Potaeeatsthis/2026-micro-con/study/voice_command_state.pdf

S0 Idle awaits for trigger words

S1 Object wait wait for user say the object

seen by pi

move / pick / grab

blue box/ green box / red box / black box

LCD show the object that user say on the screen to confirm

S2 Grasp confirm On LCD : pick BLUE BOX - yes?

yes

S3 Grasping arm move and pick the object

S4 Holding the object holded and wait

for the command

S5 Destination to designated destination

hand / station / default | | forward / backward / left / right
place / drop | | LCD : [forward 10, right 5, left 5] confirm? | The numbers on the slide bar indicate the distance of the movement in centimeters.
| pop the jog queue | | S6 Jog queue add movement step in a queue that shown on LCD
| yes

S8a Executing runs the steps in the queue

no

S7 Plan confirm LCD show the plan

yes

S8b Executing move&place, also can be

interupt by “stop”

S9 Release lower, open and retreat to home

S10 Stopped stopped but still hold the object

stop

### Lower and open the hand Go to Homeplace / drop

home

only when gripper open

GLOBAL RULE: "stop" is accepted in every state.
- while the arm moves (S3, S8a, S8b, S9, Go to Home) -> S10 Stopped
- while waiting (S1, S2, S4, S6, S7) | -> cancel, back to S0/S4

no

no

undo
