Potaeeatsthis/2026-micro-con/voice_command_research/workspace/eval/baseline_w16d2_noaug/S0/clip_confusion.png

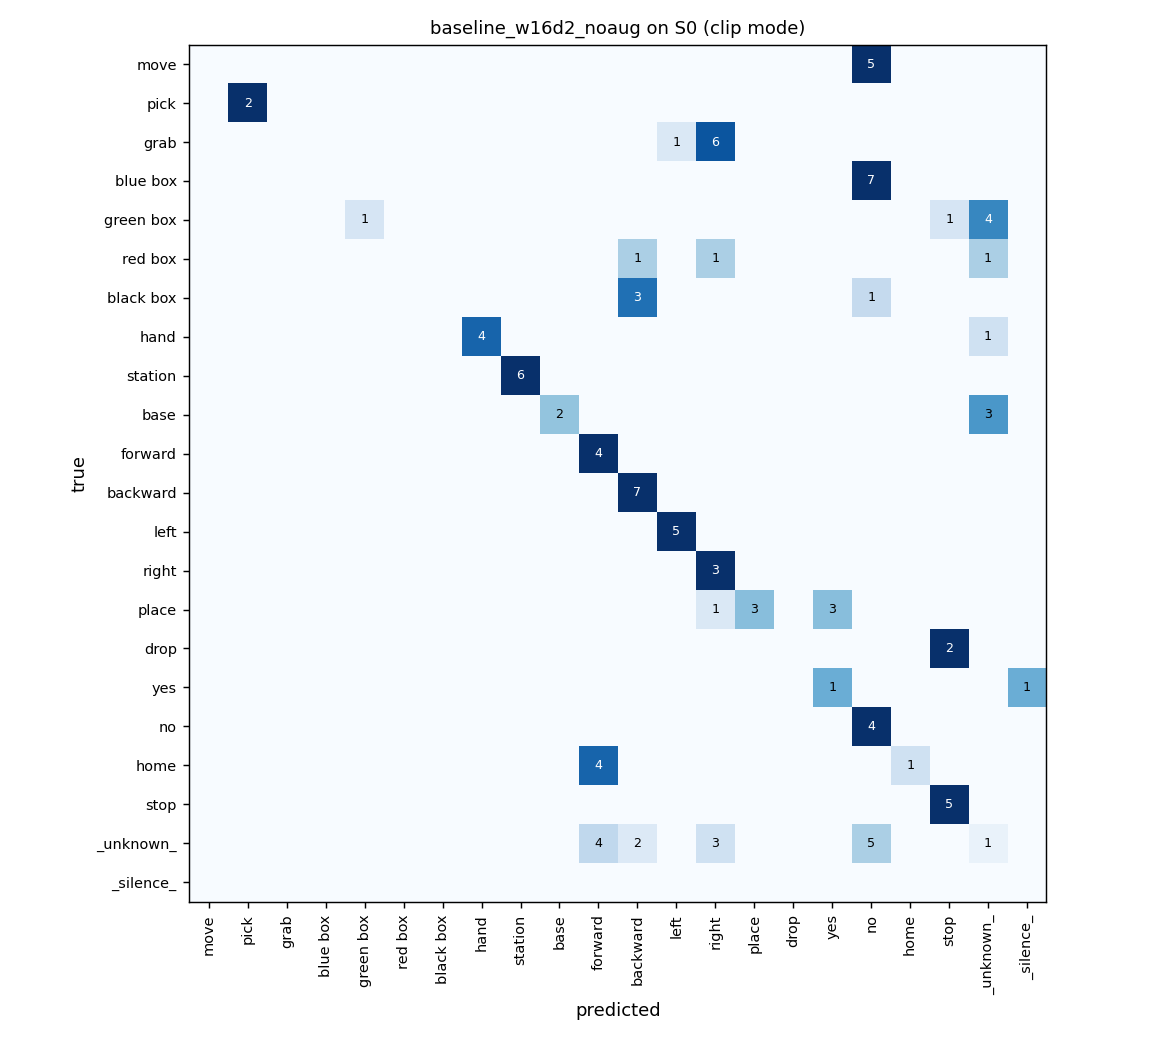
voice_command_research/workspace/eval/baseline_w16d2_noaug/S0/clip_confusion.png
