Potaeeatsthis/2026-micro-con/study/robotic-arm-budget.xlsx

Sheet: Parts List
Parts List
Microcontroller Project · Third Year Computer Engineering · Budget cap ฿5,000 · Updated 8 September 2026
# | Part | Why we need it | Qty | Price each | Total | Where to buy | Link | Price checked?
 | MG996R servo motor | The three heavy joints: base rotation, shoulder and elbow. These carry the whole weight of the arm above them. We buy 4 so there is 1 spare, because a burnt motor mid-project costs a week. | 4 | ฿139 | ฿556 | ModuleMore | Buy here (https://www.modulemore.com/en/product/524/เซอร์โว-0-180-องศา-mg996r-servo-robot-รุ่นอัพเกรดจาก-mg995-เฟืองโลหะล้วน) | Yes, price seen
 | SG90 Micro Servo Motor + Horn | The three light joints: wrist pitch, wrist rotation and the gripper. Small and light, which matters because every gram out here multiplies the load on the shoulder. 4 for 1 spare. | 4 | ฿70 | ฿280 | Cybertice | Buy here (https://www.cybertice.com/product/935/sg90-micro-servo-motor-แบบ-หมุน360องศาต่อเนื่อง) | Yes, price seen
 | SN74AHCT244N DIP-20 logic buffer | Receives the six 3.3 V STM32 hardware-PWM signals and outputs reliable 5 V servo-control signals. One eight-channel chip supports all six servos. Servo power does not pass through this chip. | 1 | ฿38 | ฿38 | DigiKey Thailand | https://www.ti.com/product/SN74AHCT244 (https://www.modulemore.com/product/9/pca9685-16-channel-pwm-servo-driver) | Yes, price seen
 | INMP441 I2S microphone | Voice input to the Pi. | 3 | ฿85 | ฿255 | Cybertice | Buy here (https://www.cybertice.com/product/4718/inmp441-โมดูลไมโครโฟนรอบทิศทาง-omnidirectional-microphone-module-i2s-interface-mems) | Yes, price seen
 | 10kΩ Potentiometer | One knob per joint for a manual jog mode. Not needed for autonomous operation, but reading 6 ADC channels is real microcontroller work, and it is how you calibrate each joint and demo the arm if speech or vision fails on the day. | 6 | ฿10 | ฿60 | Cybertice | Buy here (https://www.cybertice.com/product/190/wh148-ตัวต้านทานปรับค่าได้-10k-ohm-b10k-volume-vr-potentiometer-variable-resistor) | Yes, price seen
 | Ball bearing 6806ZZ, 30x42x7 | Press-fits into the base. It sits between the fixed base plate and the rotating platform so the base servo is not carrying the arm weight sideways through its own gears. | 1 | ฿132 | ฿132 | Duraprothai | Buy here (https://www.duraprothai.com/product/193478-191425/6806zz-ตลับลูกปืนเม็ดกลมร่องลึก-deep-groove-ball-bearing-30x42x7-mm) | Yes, price seen
 | Fillament(PLA) | Filament (PLA) |  |  | ฿0
 | PETG filament, 1 kg | All the printed arm parts. | 1 | ฿390 | ฿390 | Siamreprap | Buy here (https://siamreprap.bentoweb.com/th/product/1319033/clear-petg-Polylite-Polymaker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) | Yes, price seen
 | LiPo battery, 3S 11.1 V, 2200 mAh, XT60 | Powers the whole robot so it does not need a wall socket. 3S gives 11.1 V nominal. | 1 | ฿590 | ฿590 | Shopee | Buy here (https://shopee.co.th/แบตเตอรี่-Lipo-3S-11.1V-2200mah-35C-สำหรับ-รถบังคับ-เรือ-เครื่องบิน-โดรน-i.17068752.18734467964) | Yes, price seen
 | Buck converter, 20 A 300 W, set to 6.0 V | SERVO RAIL. Battery down to 6.0 V, feeding servos only. Rated 15 A continuous against our 9.75 A worst case. This is what replaces the AAA plan. | 1 | ฿220 | ฿220 | Cybertice | Buy here (https://www.cybertice.com/product/3656/โมดูลแปลงแรงดันลง-20a-300w-step-down-buck-converter-6-40v-to-1-2-35v) | Yes, price seen
 | Buck converter, 5 A, set to 5.1 V | PI RAIL. A separate step-down for the Raspberry Pi. Keeping the Pi off the servo rail is what stops it rebooting every time the arm moves. | 1 | ฿70 | ฿70 | Adruniotics | Buy here (https://www.arduitronics.com/product/3673/step-down-module-sy8205-แปลงไฟจาก-7-24v-เป็น-5v-กระแสสูงสุด-5a-แถมฟรี-pin-headers) | Yes, price seen
 | 100 nF ceramic decoupling capacitor | Connect directly between SN74AHCT244N pin 20 (VCC) and pin 10 (GND). It filters short supply spikes near the logic buffer. | 1 | ฿5 | ฿5 | Local electronics shop | https://www.ti.com/product/SN74AHCT244 (https://shopee.co.th/(1ชิ้น)-NA019-โมดูลแปลงระดับสัญญาณ-logic-4-ช่อง-i2c-5v-เป็น-3.3v-2-ช่อง-IIC-I2C-Logic-Level-Converter-Bi-Directional-...-i.944231623.2098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) | Estimated
 | M2 × 10 mm DIN912 Hex Socket Bolt (20)(5Baht) = 100B M1.6 × 4 mm DIN912 Hex Socket Bolt (10)(8Baht) = 80B M2.5 × 14 mm DIN912 Hex Socket Bolt (20)(4Baht) = 80B | For constructing the 3D printed robotic arm. | 1 | ฿260 | ฿260 | Shopee | Buy here (https://shopee.co.th/-ZY02-TH-X-Hex-Socket-Head-Cap-Machine-Screw-DIN912-น็อตดำ-หัวจม-M1.6-M5-เกรด-12.9-แข็งพิเศษ-สกรูชุบแข็งดำ-เกลียวมิล-i.1381664208.2871545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) | Yes, price seen
 | M2 DIN985 Nyloc Nut (10/set)(5Baht) M2.5 DIN985 Nyloc Nut (10/set)(5Baht) M1.6 DIN934 Hex Nut (10/set)(5Baht) | For constructing the 3D printed robotic arm. | 1 | ฿15 | ฿15 | Shopee | Buy here (https://shopee.co.th/product/1573566645/40768757159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) | Yes, price seen
 | 12 V DC power adapter, 10 A (sealed brick) | Servo power. Feeds the 20 A buck at 6.0 V, so servo conditions match deployment exactly and we test the buck early instead of in the final week. | 1 | ฿215 | ฿215 | ModuleMore | Buy here (https://shopee.co.th/20-JCY-1210-SET-อแดปเตอร์-อะแดปเตอร์-adapter-12v-10a-i.12149540.3343064258) | Yes, price seen
 | Barrel jack to screw terminal adapter (female) | Lets the 12 V adapter plug into the buck without cutting its cable. | 1 | ฿16 | ฿16 | Cytron | Buy here (https://th.cytron.io/p-dc-jack-female-to-screw-terminal-adapter) | Yes, price seen | shopee หมด
 | Terminal block, 12CH, 15A/600V | TWO needed. One strip = PLUS bus (bare wire under all 12 left screws, 12 right screws free for buck+, 6 servo reds, 3 capacitor + legs). Second strip = MINUS bus (buck−, 6 servo blacks, 3 capacitor − legs, 1 wire to Pi/STM32 ground). Splitting one strip 6/6 leaves only 6 usable screws per bus, which is not enough. | 2 | ฿29 | ฿58 | s2ins | Buy here (https://s2ins.com/product/screw-terminal-block-12ch-tb1512-15a-600v/) | Yes, price seen
 | XT60 connector pair male (with 14 AWG pre-soldered) | The yellow RC battery plug. Your pack has one half; you buy the mating half to solder to your wiring so the battery unplugs for charging. | 1 | ฿26 | ฿26 | Shopee | Buy here (https://shopee.co.th/product/428425779/27982717310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) | Yes, price seen
 | Silicone wire 14 AWG + 18 AWG | 14 AWG (2 m red + 2 m black): adapter to buck, buck to Block A, battery junction to both bucks, plus ~30 cm cut into short bus links bridging terminal screws. 18 AWG (1 m + 1 m): Block A out to each servo. Silicone insulation stays flexible on a moving arm. NOT jumper wire — that melts at these currents. | 1 | ฿120 | ฿120 | Shopee | Buy here (https://shopee.co.th/สายไฟซิลิโคน-สายไฟทองแดง-100-แท้-สายอ่อน-ทนความร้อนสูง-8awg-10awg-12awg-14awg-16awg-18awg-20awg-Silicone-200องศา-i.368104632.19578423924) | Yes, price seen
 | Capacitors, 2200 uF 16 V, x3 | Mount across the terminal block. They supply the instant a servo starts, before the converter can react. Three in parallel react faster than one big one. | 3 | ฿50 | ฿150 | Shopee | Buy here (https://shopee.co.th/product/312289360/12295248404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) | Yes, price seen
 | USB-A to micro-USB cable | For connecting Pi - STM32 using UART protocols | 1 | ฿65 | ฿65 | Shopee | Buy here (https://shopee.co.th/สาย-Micro-USB-Type-B-to-USB-2.0-Type-A-ยาว-50CM-มีสินค้าในไืนพร้อมส่งทุกวัน-i.755103386.28367373991) | Yes, price seen
 | Heat shrink tubing | Insulates the XT60 solder split where both buck input pairs join the battery pigtail. Bare copper next to a LiPo is a short waiting to happen. | 1 | ฿102 | ฿102 | Shopee | Buy here (https://shopee.co.th/10M-Heat-Shrink-Tube-2-1-Polyolefin-Diameter-0.6mm-0.8mm-1mm-1.5mm-2mm-2.5mm-3mm-หดความร้อนหลอด-โพลีโลฟินเส้นผ่านศูนย์กลาง-ความร้อนสายแขน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) | Yes, price seen
 | Jumper wires, 3 x 40-way sets | *** เราอาจจะมีอยู่แล้ว *** Male-male and male-female | 1 | ฿120 | ฿120 | ModuleMore | Buy here (https://www.modulemore.com/en/category/43/jumper-connector-protoboard) | Yes, price seen
 | B3 Balance Charger 20 W for 2S / 3S LiPo | A 3S LiPo must only be charged on a proper balance charger. | 1 | ฿245 | ฿245 | cybertice | Buy here (https://www.cybertice.com/product/5590/เครื่องชาร์จแบตเตอรี่ลิเธียมชาร์จประจุกระแสสูงได้อย่างรวดเร็ว-lipo-imax-rc-b3-20w-2s-3s-7-4v-11-1v) | Yes, price seen
 | STM32 board (STM32F767ZI) | Already have it. Generates six stable hardware-PWM signals, reads the controls and safety inputs, plans smooth trajectories, and communicates with the Pi over USB UART. | 1 | ฿0 | ฿0 | We have it |  | Free
 | Raspberry Pi 4 | Already have it. Speech, camera, joint angle maths, and sending commands to the STM32. | 1 | ฿0 | ฿0 | We have it |  | Free
 | Breadboard | Holds the 6 potentiometers and their wiring tidily. | 1 | ฿0 | ฿0 | We have it |  | Free
 | RGB-D camera | Borrowed from a friend. It finds the cube and measures how far away it is. | 1 | ฿0 | ฿0 | Borrowed |  | Free
 | Parts total |  |  |  | ฿3988 |  |  | Passed
 | Shipping | We order from about 3 shops. Each charges ฿50 to ฿70. |  |  | ฿250 |  |  | In review
 | Spare money | In case we burn a motor, buy the wrong screws, or a guessed price is too low. |  |  | ฿300
 | TOTAL |  |  |  | ฿4538
 | 3
 | Optional extras, NOT included in the total above
 | Part | When we would buy it |  | Price |  | Where | Link
 | 8th MG996R, second spare | Top budgeted 2 spares. We budget 1. Add this if motors start dying. |  | ฿139 |  | ModuleMore | Buy here
 | Emergency stop button 22 mm | ADDED. LAY37-11ZS mushroom latching, 1NO+1NC, 10 A. Press to stop the arm when the code sends it somewhere wrong — the fuse cannot detect that. |  | ฿45 |  | Vongjorn | Buy here (https://www.vongjorn.com/product/5207/emergency-stop-button-lay37-11zs-1no-1nc)
 | DS3218 20 kg-cm servo | Only if the shoulder droops when the arm reaches out. Buy it after we build the arm and see, not before. |  | ฿500 |  | Shopee | Buy here
 | FINAL CONTROL AND POWER ARCHITECTURE
 | Control | Raspberry Pi → USB UART → STM32 → six hardware-PWM channels → SN74AHCT244N → servo signal wires
 | Servo power | 12 V adapter or 3S LiPo → 20 A buck set to 6.0 V → distribution block → servo red and black wires
 | Logic power | 5.1 V regulated rail → Raspberry Pi and logic; SN74AHCT244N uses 5 V logic power
 | Ground | Pi, STM32, SN74AHCT244N, both buck converters and all servos share one common ground
 | Removed | PCA9685 and BSS138 I²C level shifter are not part of the final architecture

Sheet: Where To Buy (Options)
Where To Buy (options ranked cheapest first)
For each part, the cheapest option is listed first. The last column says what you give up by going cheap, so you can decide where it matters. Rows marked OUR PICK are what the Parts List uses.
Option | Price | Shop | Link | What you gain or give up
SERVOS — MG996R (need 4)
MG996R | ฿139 | ModuleMore SKU-00524 | Open (https://www.modulemore.com/en/product/524/mg996r-servo) | OUR PICK. Cheapest confirmed Thai price. 30-day warranty. Buy all 4 here.
MG996R | ฿160 | Cybertice | Open (https://www.cybertice.com/product/63/mg996r-servo-motor) | Backup if ModuleMore is out of stock. Same part, ฿21 more.
MG996R TowerPro genuine | ฿175 | Arduitronics | Open (https://www.arduitronics.com/product/440/high-torque-servo-motor-mg996r-tower-pro-180-degree) | Genuine TowerPro branding. Marketplaces have a lot of fakes; if you have had a bad servo before, pay the extra ฿36.
SERVOS — SG90 (need 4)
SG90 9g | ฿55 | Shopee multipack | Open | Cheapest per unit in packs of 5 or 10. Quality varies between sellers, so read reviews.
SG90 + horn | ฿70 | Cybertice | Open (https://www.cybertice.com/product/62/sg90-micro-servo-9g) | OUR PICK. Comes with horns, which you need. Known shop.
MG90S metal gear | ฿130 | Shopee | Open | Metal gears instead of plastic. Worth it only if you strip an SG90 gear during testing.
LOGIC BUFFER — SN74AHCT244N DIP-20 (need 1)
SN74AHCT244N, PDIP-20 | ฿38 | DigiKey Thailand | https://www.ti.com/product/SN74AHCT244 (https://www.modulemore.com/product/9/pca9685-16-channel-pwm-servo-driver) | OUR PICK. Exact final part: AHCT accepts 3.3 V STM32 signals reliably while powered from 5 V. Through-hole package fits a breadboard.
SN74AHCT244N, PDIP-20 | ฿45 | Mouser | https://www.ti.com/product/SN74AHCT244 (https://www.modulemore.com/product/9/pca9685-16-channel-pwm-servo-driver) | Same exact device from another distributor. Shipping cost may be higher than the chip price.
SN74HCT244N, PDIP-20 | ฿41.2 | element14 Thailand | https://www.ti.com/product/SN74AHCT244 (https://www.analogread.com/product/612/pca9685-16ch-servo-driver) | Backup only. HCT has less input-voltage margin than AHCT at 5 V, so keep SN74AHCT244N as the final choice.
BATTERY — 3S LiPo
GPR 3S 2200mAh budget | ฿420 | UDSHobby | Open (http://www.udshobby.com/category/27/battery/3s-11-1v) | Cheapest option. Lower C-rating and less consistent. We only need 1.2C so it would work, but cheap packs swell sooner.
ManiaX 3S 2200mAh 30C XT60 | ฿550 | UDSHobby | Open (http://www.udshobby.com/product/27/lipo-maniax-2200mah-11-1v-3s-30c-xt60) | OUR PICK. Shop checks cells before shipping. XT60 already fitted, correct C-rating with margin.
ManiaX 3S 2600mAh 60C XT60 | ฿750 | UDSHobby | Open (http://www.udshobby.com/category/27/battery/3s-11-1v) | More capacity means longer runtime, roughly 50 min instead of 40. Only worth it if debugging sessions run long.
SERVO RAIL CONVERTER
LM2596 3 A module | ฿45 | Shopee | Open | DO NOT USE for servos. Only 3 A, far under our 9.75 A worst case. Listed so you can see why the cheap one fails.
XL4016 8 A 200 W | ฿120 | Shopee | Open | Would cover normal movement at 2.4 A but not a stall. Risky.
20 A 300 W buck | ฿220 | Cybertice / Shopee | Open | OUR PICK. 15 A continuous against our 9.75 A worst case. Add a fan if it runs hot.
PI RAIL CONVERTER
LM2596 3 A adjustable | ฿45 | Shopee | Open | Marginal. Pi plus camera plus STM32 peaks at 2.7 A, leaving almost no headroom.
SY8205 5 A | ฿70 | Arduitronics / Shopee | Open | OUR PICK. 5 A against a 2.7 A peak is comfortable margin for ฿25 more.
8 A adjustable buck | ฿130 | Shopee | Open | More than needed. Only if you later add USB devices.
EMERGENCY STOP BUTTON
16 mm push button | ฿35 | Shopee | Open | Too small to hit in a hurry and often momentary rather than latching. Not suitable for an e-stop.
22 mm mushroom latching NC | ฿90 | Shopee | Open | OUR PICK. Proper mushroom head, latches when pressed, normally-closed contact. This is what an e-stop should be.
Industrial e-stop, IP65 | ฿250 | PT Automation | Open (https://www.pt-automationparts.com/en/category/94/limit-switch) | Sealed industrial grade. Overkill for a desk robot but if the professor values safety marks, it shows intent.
RELAY for the e-stop circuit
5 V PCB relay 10 A | ฿30 | Shopee | Open | Contacts only rated 10 A. Our worst case is 9.75 A, so it sits right at the limit. No margin.
12 V automotive 30 A + socket | ฿75 | Shopee | Open | OUR PICK. 30 A contacts against 9.75 A. Socket makes it replaceable without soldering. Coil pulls in fine at 11.1 V.
Contactor 25 A DC | ฿320 | Shopee | Open | Proper DC contactor. Better arc handling but large, expensive and unnecessary at this current.
LIMIT SWITCHES (need 4)
KW11 micro switch | ฿15 | ModuleMore SKU-02128 | Open (https://www.modulemore.com/en/category/122/limit-switch-sensor) | OUR PICK. Standard micro switch with lever. Exactly what a 3D printer endstop uses.
3D printer endstop board | ฿35 | ModuleMore SKU-00391 | Open (https://www.modulemore.com/en/category/122/limit-switch-sensor) | Switch on a small PCB with a connector and LED. Tidier wiring, easier to mount, ฿20 more each.
OMRON D4V industrial | ฿250 | PT Automation | Open (https://www.pt-automationparts.com/en/category/94/limit-switch) | Industrial 5 A IP65. Massively over-specified for detecting a plastic arm reaching its stop.
BREADBOARD
400 point + jumper kit | ฿75 | AB Maker | Open (https://www.ab.in.th/category/41/accessories/breadboard) | Includes some jumpers and LEDs. Small but enough for 6 potentiometers if you are tight.
MB-102 830 point | ฿90 | ModuleMore SKU-00037 | Open (https://www.modulemore.com/en/product/37/breadboard-mb102-830-tie-points-solderless) | OUR PICK. Full size, room for the pots plus anything you add later.
830 point + power rails + case | ฿180 | Shopee | Open | Mounted on a plate with binding posts. Tidier but not needed.
JUMPER WIRES
65-wire breadboard pack | ฿60 | ModuleMore SKU-00034 | Open (https://www.modulemore.com/en/product/34/jumper-breadboard-65) | Stiff pre-formed wires. Good on a breadboard, useless for reaching between boards.
3 x 40-way dupont sets | ฿120 | ModuleMore | Open (https://www.modulemore.com/en/category/43/jumper-connector-protoboard) | OUR PICK. Male-male, male-female and female-female. Covers every connection in this project.
840 piece full kit | ฿180 | ModuleMore SKU-02871 | Open (https://www.modulemore.com/product/2871/840pcs-breadboard-jumper-wire-kit-u-shape) | Confirmed ฿180. Huge kit with a case. Buy if you want spares for future projects.
FILAMENT
PLA 1 kg | ฿350 | Shopee | Open | What the reference uses. Prints easier but slowly bends under sustained load, which our joints have.
PETG 1 kg | ฿390 | Siamreprap / Shopee | Open (https://www.siamreprap.com/product-category/filament/) | OUR PICK. Tougher, does not creep. Needs a slightly hotter nozzle. One spool covers the arm.
ABS 1 kg | ฿550 | Siamreprap | Open (https://www.siamreprap.com/product-category/filament/) | Strongest and most heat resistant, but needs an enclosed printer and good ventilation. Only if you have that printer.
SCREWS AND NUTS
Assorted DIN912 box M2-M6 | ฿260 | Lazada | Open (https://www.lazada.co.th/products/m2-m25-m3-m4-m5-m6-304-din912-hex-socket-head-cap-machine-screw-i4250262580.html) | OUR PICK. 304 stainless, covers every size we need plus spares for stripped threads. Cheaper than buying sizes separately.
Individual sizes | ฿300 | SJ ScrewThai | Open (https://www.screwthai.co.th/) | Thai manufacturer, ISO 9001. Use when you need a lot of one size, or a size the box omits.
Small nuts M1.6 and M2 | ฿120 | RemoThai | Open (https://www.remothai.com/category/11/) | DIN934 and ISO4032 nuts from M2 up, no minimum order. Assortment boxes often skip the tiny nuts, so budget for this too.
BEARING 6806ZZ
Generic 6806ZZ | ฿132 | Shopee | Open | OUR PICK. 30x42x7 mm. Any bearing shop stocks it. Get the ZZ metal-shielded version.
NSK or NTN branded | ฿350 | Bearing distributor | Open | Japanese brand, smoother and longer life. The base turns slowly and rarely, so a generic is fine here.
How to order to avoid buying twice
- Print ONE test part before buying screws. M2 is slightly smaller than the No.2-32 the original design used, so the holes may need resizing in CAD. Changing a hole is free, a wrong box of screws is not.
- Group by shop. Buy the exact SN74AHCT244N, not a normal 74HC244. The AHCT input thresholds are suitable for 3.3 V STM32 signals while the chip runs at 5 V.
- Buy the servos LAST from the confirmed cheap source, once you know the printed parts fit them.
- Do not buy the DS3218 upgrade servo in advance. Fit the spring first, then judge whether the shoulder still droops.
- Check the LiPo is not swollen the day it arrives. A swollen pack is not usable and returns get harder after a week.

Sheet: If Something Goes Wrong
Problems and Backup Plans
Red rows are things that will definitely go wrong if we do not change them. To be discussed as a group.
Problem | What actually happens | What we do instead | Cost | Link
Servo current sent through the SN74AHCT244N | The logic-buffer pins cannot carry motor current and may be damaged. | Only the orange PWM signal wire passes through the buffer. Servo red and black wires connect to the separate 6.0 V distribution block. | ฿0 | https://www.ti.com/product/SN74AHCT244
E-stop button wired directly in the power path | A ฿90 button switching 9.75 A will weld its contacts shut and silently stop protecting anyone. | Button drives the relay coil only. The 30 A relay contacts carry the servo current. | ฿75 | Open
Metric screws do not fit the printed holes | The original design used imperial No.2-32 and No.3-28 truss-head screws. M2 is slightly smaller, so our screws may sit loose. | Print ONE test part first and check the fit before ordering in bulk. | ฿0 | Open (https://www.lazada.co.th/products/m2-m25-m3-m4-m5-m6-304-din912-hex-socket-head-cap-machine-screw-i4250262580.html)
M3 hardware is missing from our list | The reference needs M3x16, M3x6, M3x20 and M3 nuts for the arm links and gripper. Our fastener list has none of these. | Confirm whether the CAD holes were resized. If not, the assorted box covers M3 anyway. | ฿0 | Open (https://www.lazada.co.th/products/m2-m25-m3-m4-m5-m6-304-din912-hex-socket-head-cap-machine-screw-i4250262580.html)
Shoulder servo droops when the arm extends | MG996R gives about 11 kg-cm at 6 V and a fully extended arm asks for close to that. It buzzes, heats and sags out of position. | Fit the spring first. Only if it still droops, replace the shoulder servo with a DS3218 at 20 kg-cm. | ฿500 | Open
Printed parts creep or crack | PLA slowly bends under constant load and cracks around screw holes. | Print in PETG at 0.2 mm layers, 40% infill or more on the base and arm links. | ฿390 | Open (https://www.siamreprap.com/product-category/filament/)
Nuts vibrate loose | A moving arm shakes plain nuts undone within hours of testing. | DIN985 nyloc nuts, which is why they are on the list. Threadlock also works. | ฿0 | Open (https://www.remothai.com/category/11/)
Servo PWM becomes unstable | Software-generated PWM, timer conflicts or a floating output-enable pin can cause jitter or unexpected movement. | Use STM32 hardware timers, hold both SN74AHCT244N output-enable pins LOW, fit a 100 nF capacitor at the chip, and verify the final pins in CubeMX. | ฿5 | https://www.ti.com/product/SN74AHCT244
Pi shows undervoltage warnings | Pi USB ports supply 1.2 A total. Camera 0.7 A plus STM32 0.25 A is 79% of that before anything else. | Power the Nucleo from its own adapter and keep the ground tied to the common bar. | ฿0 | Open (https://www.cybertice.com/)
Battery runs out mid-testing | A 2200 mAh pack at about 2.6 A gives roughly 40 minutes. Debug sessions run longer. | Bench-test from a wall supply through the same converters. Save the battery for the demo. | ฿0 | Open (http://www.udshobby.com/category/27/battery/3s-11-1v)
Gripper misses the cube by 1 to 2 cm | Servo deadband, not a software bug. MG996R has 1 to 2 degrees of play, which is 5 to 10 mm at 30 cm reach. | Use 4 cm cubes, rubber pads inside the gripper, approach from directly above. | ฿150 | Open
Speech works badly in a noisy room | One omnidirectional microphone hears the servos as well as you. | Mount it away from the arm, only listen while the arm is still, restrict to fixed command phrases. | ฿85 | Open
