Potaeeatsthis/2026-micro-con/voice_command_research/workspace/experiments/exp01_tcresnet-w16d2_aug-all/results/board/exp01_tcresnet-w16d2_aug-all/S0/clip_predictions.csv

clip_path | word | label | pred | correct | p_pred | p_true | rank_true | top3 | speech_peak_db | snr_db | quality_ok | flags
clips/supanut/S0/move/move_01.wav | move | move | move | 1 | 0.9644 | 0.9644 | 1 | move 0.96 | no 0.01 | _unknown_ 0.00 | -39.8 | 25.49 | True | S0 old wiring (VDD ~1.8 V)
clips/supanut/S0/stop/stop_01.wav | stop | stop | stop | 1 | 0.9688 | 0.9688 | 1 | stop 0.97 | red box 0.01 | drop 0.01 | -28.7 | 23.05 | True | S0 old wiring (VDD ~1.8 V)
clips/supanut/S0/black_box/black_box_01.wav | black box | black box | black box | 1 | 0.7047 | 0.7047 | 1 | black box 0.70 | red box 0.13 | backward 0.03 | -25.9 | 24.02 | True | S0 old wiring (VDD ~1.8 V)
clips/supanut/S0/grab/grab_01.wav | grab | grab | grab | 1 | 0.71 | 0.71 | 1 | grab 0.71 | left 0.12 | right 0.06 | -28.3 | 27.57 | True | S0 old wiring (VDD ~1.8 V)
clips/supanut/S0/home/home_01.wav | home | home | home | 1 | 0.9658 | 0.9658 | 1 | home 0.97 | hand 0.02 | _unknown_ 0.01 | -38.9 | 20.59 | False | sound longer than 1 s - the clip cuts it; S0 old wiring (VDD ~1.8 V)
clips/supanut/S0/blue_box/blue_box_01.wav | blue box | blue box | blue box | 1 | 0.4381 | 0.4381 | 1 | blue box 0.44 | no 0.17 | green box 0.15 | -34.3 | 24.12 | True | S0 old wiring (VDD ~1.8 V)
clips/supanut/S0/home/home_02.wav | home | home | home | 1 | 0.9013 | 0.9013 | 1 | home 0.90 | hand 0.05 | move 0.01 | -38.6 | 22.69 | True | S0 old wiring (VDD ~1.8 V)
clips/supanut/S0/red_box/red_box_01.wav | red box | red box | red box | 1 | 0.9641 | 0.9641 | 1 | red box 0.96 | green box 0.02 | grab 0.01 | -32.9 | 23.21 | False | sound longer than 1 s - the clip cuts it; S0 old wiring (VDD ~1.8 V)
clips/supanut/S0/place/place_01.wav | place | place | place | 1 | 0.9366 | 0.9366 | 1 | place 0.94 | base 0.03 | _unknown_ 0.01 | -33.3 | 20.91 | True | S0 old wiring (VDD ~1.8 V)
clips/supanut/S0/backward/backward_01.wav | backward | backward | backward | 1 | 0.9949 | 0.9949 | 1 | backward 0.99 | black box 0.00 | left 0.00 | -26.3 | 24.63 | True | S0 old wiring (VDD ~1.8 V)
clips/supanut/S0/station/station_01.wav | station | station | station | 1 | 0.9631 | 0.9631 | 1 | station 0.96 | base 0.03 | place 0.00 | -29.4 | 20.78 | True | S0 old wiring (VDD ~1.8 V)
clips/supanut/S0/pick/pick_01.wav | pick | pick | pick | 1 | 0.9958 | 0.9958 | 1 | pick 1.00 | right 0.00 | _unknown_ 0.00 | -34.6 | 16.65 | True | S0 old wiring (VDD ~1.8 V)
clips/supanut/S0/black_box/black_box_02.wav | black box | black box | black box | 1 | 0.839 | 0.839 | 1 | black box 0.84 | backward 0.05 | left 0.03 | -27.1 | 22.08 | True | S0 old wiring (VDD ~1.8 V)
clips/supanut/S0/hand/hand_01.wav | hand | hand | hand | 1 | 0.721 | 0.721 | 1 | hand 0.72 | pick 0.09 | right 0.08 | -29.4 | 19.99 | True | S0 old wiring (VDD ~1.8 V)
clips/supanut/S0/_unknown_/pink_01.wav | pink | _unknown_ | pick | 0 | 0.9386 | 0.0179 | 2 | pick 0.94 | _unknown_ 0.02 | hand 0.02 | -34.5 | 19.61 | True | S0 old wiring (VDD ~1.8 V)
clips/supanut/S0/move/move_02.wav | move | move | hand | 0 | 0.604 | 0.1029 | 2 | hand 0.60 | move 0.10 | pick 0.08 | -37.4 | 22.06 | True | S0 old wiring (VDD ~1.8 V)
clips/supanut/S0/backward/backward_02.wav | backward | backward | backward | 1 | 0.9987 | 0.9987 | 1 | backward 1.00 | black box 0.00 | _unknown_ 0.00 | -27.2 | 21.24 | True | S0 old wiring (VDD ~1.8 V)
clips/supanut/S0/green_box/green_box_01.wav | green box | green box | green box | 1 | 0.9688 | 0.9688 | 1 | green box 0.97 | _unknown_ 0.01 | blue box 0.00 | -34.2 | 24.95 | True | S0 old wiring (VDD ~1.8 V)
clips/supanut/S0/base/base_01.wav | base | base | base | 1 | 0.8948 | 0.8948 | 1 | base 0.89 | place 0.09 | _unknown_ 0.00 | -36.9 | 21.05 | True | S0 old wiring (VDD ~1.8 V)
clips/supanut/S0/green_box/green_box_02.wav | green box | green box | green box | 1 | 0.9583 | 0.9583 | 1 | green box 0.96 | blue box 0.01 | _unknown_ 0.01 | -34.0 | 23.11 | False | word touches the edge of the 2 s take; sound longer than 1 s - the clip cuts it; S0 old wiring (VDD ~1.8 V)
clips/supanut/S0/no/no_01.wav | no | no | no | 1 | 0.9781 | 0.9781 | 1 | no 0.98 | move 0.01 | home 0.00 | -34.8 | 24.35 | True | S0 old wiring (VDD ~1.8 V)
clips/supanut/S0/blue_box/blue_box_02.wav | blue box | blue box | blue box | 1 | 0.6563 | 0.6563 | 1 | blue box 0.66 | green box 0.08 | no 0.06 | -35.3 | 20.71 | False | word touches the edge of the 2 s take; sound longer than 1 s - the clip cuts it; S0 old wiring (VDD ~1.8 V)
clips/supanut/S0/_unknown_/nose_01.wav | nose | _unknown_ | no | 0 | 0.9524 | 0.0068 | 2 | no 0.95 | _unknown_ 0.01 | red box 0.01 | -34.5 | 24.64 | True | S0 old wiring (VDD ~1.8 V)
clips/supanut/S0/place/place_02.wav | place | place | place | 1 | 0.8043 | 0.8043 | 1 | place 0.80 | base 0.13 | _unknown_ 0.02 | -34.1 | 16.09 | False | sound longer than 1 s - the clip cuts it; S0 old wiring (VDD ~1.8 V)
clips/supanut/S0/hand/hand_02.wav | hand | hand | hand | 1 | 0.9802 | 0.9802 | 1 | hand 0.98 | home 0.01 | _unknown_ 0.01 | -34.0 | 20.12 | True | S0 old wiring (VDD ~1.8 V)
clips/supanut/S0/right/right_01.wav | right | right | right | 1 | 0.9984 | 0.9984 | 1 | right 1.00 | _unknown_ 0.00 | grab 0.00 | -29.1 | 26.49 | True | S0 old wiring (VDD ~1.8 V)
clips/supanut/S0/grab/grab_02.wav | grab | grab | grab | 1 | 0.8587 | 0.8587 | 1 | grab 0.86 | right 0.03 | _unknown_ 0.02 | -28.6 | 27.23 | True | S0 old wiring (VDD ~1.8 V)
clips/supanut/S0/base/base_02.wav | base | base | base | 1 | 0.9528 | 0.9528 | 1 | base 0.95 | place 0.04 | move 0.00 | -31.5 | 20.22 | True | S0 old wiring (VDD ~1.8 V)
clips/supanut/S0/green_box/green_box_03.wav | green box | green box | green box | 1 | 0.9761 | 0.9761 | 1 | green box 0.98 | _unknown_ 0.01 | blue box 0.01 | -35.7 | 22.01 | False | sound longer than 1 s - the clip cuts it; S0 old wiring (VDD ~1.8 V)
clips/supanut/S0/backward/backward_03.wav | backward | backward | backward | 1 | 0.9946 | 0.9946 | 1 | backward 0.99 | _unknown_ 0.00 | black box 0.00 | -31.1 | 18.77 | False | sound longer than 1 s - the clip cuts it; S0 old wiring (VDD ~1.8 V)
clips/supanut/S0/_unknown_/write_01.wav | write | _unknown_ | right | 0 | 0.9983 | 0.0007 | 2 | right 1.00 | _unknown_ 0.00 | grab 0.00 | -28.1 | 25.15 | True | S0 old wiring (VDD ~1.8 V)
clips/supanut/S0/backward/backward_04.wav | backward | backward | backward | 1 | 0.9991 | 0.9991 | 1 | backward 1.00 | black box 0.00 | _unknown_ 0.00 | -29.7 | 23.16 | True | S0 old wiring (VDD ~1.8 V)
clips/supanut/S0/right/right_02.wav | right | right | right | 1 | 0.999 | 0.999 | 1 | right 1.00 | _unknown_ 0.00 | pick 0.00 | -28.7 | 28.42 | True | S0 old wiring (VDD ~1.8 V)
clips/supanut/S0/black_box/black_box_03.wav | black box | black box | black box | 1 | 0.3999 | 0.3999 | 1 | black box 0.40 | red box 0.16 | yes 0.16 | -29.9 | 23.37 | True | S0 old wiring (VDD ~1.8 V)
clips/supanut/S0/green_box/green_box_04.wav | green box | green box | green box | 1 | 0.9831 | 0.9831 | 1 | green box 0.98 | _unknown_ 0.01 | blue box 0.00 | -35.2 | 21.01 | False | sound longer than 1 s - the clip cuts it; S0 old wiring (VDD ~1.8 V)
clips/supanut/S0/base/base_03.wav | base | base | base | 1 | 0.8666 | 0.8666 | 1 | base 0.87 | place 0.12 | move 0.00 | -34.8 | 20.77 | True | S0 old wiring (VDD ~1.8 V)
clips/supanut/S0/_unknown_/mood_01.wav | mood | _unknown_ | move | 0 | 0.8239 | 0.03 | 3 | move 0.82 | forward 0.04 | _unknown_ 0.03 | -39.7 | 22.31 | True | S0 old wiring (VDD ~1.8 V)
clips/supanut/S0/green_box/green_box_05.wav | green box | green box | green box | 1 | 0.9449 | 0.9449 | 1 | green box 0.94 | _unknown_ 0.02 | blue box 0.01 | -35.7 | 25.31 | True | S0 old wiring (VDD ~1.8 V)
clips/supanut/S0/red_box/red_box_02.wav | red box | red box | red box | 1 | 0.9733 | 0.9733 | 1 | red box 0.97 | green box 0.01 | grab 0.01 | -33.0 | 23.01 | True | S0 old wiring (VDD ~1.8 V)
clips/supanut/S0/stop/stop_02.wav | stop | stop | stop | 1 | 0.9966 | 0.9966 | 1 | stop 1.00 | _unknown_ 0.00 | drop 0.00 | -29.0 | 23.27 | True | S0 old wiring (VDD ~1.8 V)
clips/supanut/S0/backward/backward_05.wav | backward | backward | backward | 1 | 0.9988 | 0.9988 | 1 | backward 1.00 | black box 0.00 | _unknown_ 0.00 | -28.8 | 24.01 | True | S0 old wiring (VDD ~1.8 V)
clips/supanut/S0/blue_box/blue_box_03.wav | blue box | blue box | no | 0 | 0.307 | 0.3032 | 2 | no 0.31 | blue box 0.30 | move 0.07 | -35.9 | 23.84 | True | S0 old wiring (VDD ~1.8 V)
clips/supanut/S0/home/home_03.wav | home | home | home | 1 | 0.9921 | 0.9921 | 1 | home 0.99 | hand 0.00 | _unknown_ 0.00 | -41.5 | 21.88 | True | S0 old wiring (VDD ~1.8 V)
clips/supanut/S0/green_box/green_box_06.wav | green box | green box | green box | 1 | 0.9118 | 0.9118 | 1 | green box 0.91 | _unknown_ 0.03 | blue box 0.01 | -33.5 | 24.68 | True | S0 old wiring (VDD ~1.8 V)
clips/supanut/S0/grab/grab_03.wav | grab | grab | grab | 1 | 0.899 | 0.899 | 1 | grab 0.90 | right 0.03 | _unknown_ 0.02 | -29.0 | 27.98 | True | S0 old wiring (VDD ~1.8 V)
clips/supanut/S0/black_box/black_box_04.wav | black box | black box | black box | 1 | 0.7992 | 0.7992 | 1 | black box 0.80 | red box 0.06 | backward 0.05 | -27.8 | 25.66 | False | other sound outside the clip (2 words? click?); S0 old wiring (VDD ~1.8 V)
clips/supanut/S0/left/left_01.wav | left | left | left | 1 | 0.9012 | 0.9012 | 1 | left 0.90 | yes 0.02 | move 0.01 | -29.6 | 22.98 | True | S0 old wiring (VDD ~1.8 V)
clips/supanut/S0/grab/grab_04.wav | grab | grab | grab | 1 | 0.843 | 0.843 | 1 | grab 0.84 | right 0.05 | _unknown_ 0.02 | -29.1 | 28.08 | True | S0 old wiring (VDD ~1.8 V)
clips/supanut/S0/station/station_02.wav | station | station | station | 1 | 0.9428 | 0.9428 | 1 | station 0.94 | base 0.04 | black box 0.00 | -33.1 | 21.5 | True | S0 old wiring (VDD ~1.8 V)
clips/supanut/S0/grab/grab_05.wav | grab | grab | grab | 1 | 0.8138 | 0.8138 | 1 | grab 0.81 | left 0.08 | drop 0.02 | -29.4 | 28.1 | True | S0 old wiring (VDD ~1.8 V)
clips/supanut/S0/drop/drop_01.wav | drop | drop | drop | 1 | 0.791 | 0.791 | 1 | drop 0.79 | grab 0.17 | right 0.01 | -30.9 | 22.54 | True | S0 old wiring (VDD ~1.8 V)
clips/supanut/S0/place/place_03.wav | place | place | place | 1 | 0.9046 | 0.9046 | 1 | place 0.90 | base 0.05 | right 0.01 | -31.9 | 20.03 | True | S0 old wiring (VDD ~1.8 V)
clips/supanut/S0/move/move_03.wav | move | move | move | 1 | 0.939 | 0.939 | 1 | move 0.94 | home 0.01 | no 0.01 | -44.2 | 22.9 | True | S0 old wiring (VDD ~1.8 V)
clips/supanut/S0/no/no_02.wav | no | no | no | 1 | 0.9738 | 0.9738 | 1 | no 0.97 | _unknown_ 0.00 | move 0.00 | -37.9 | 22.01 | True | S0 old wiring (VDD ~1.8 V)
clips/supanut/S0/blue_box/blue_box_04.wav | blue box | blue box | blue box | 1 | 0.6734 | 0.6734 | 1 | blue box 0.67 | move 0.08 | no 0.06 | -34.2 | 26.78 | True | S0 old wiring (VDD ~1.8 V)
clips/supanut/S0/stop/stop_03.wav | stop | stop | stop | 1 | 0.9941 | 0.9941 | 1 | stop 0.99 | _unknown_ 0.00 | drop 0.00 | -30.1 | 19.03 | False | word touches the edge of the 2 s take; sound longer than 1 s - the clip cuts it; S0 old wiring (VDD ~1.8 V)
clips/supanut/S0/place/place_04.wav | place | place | place | 1 | 0.5144 | 0.5144 | 1 | place 0.51 | base 0.37 | _unknown_ 0.03 | -31.7 | 23.3 | True | S0 old wiring (VDD ~1.8 V)
clips/supanut/S0/grab/grab_06.wav | grab | grab | grab | 1 | 0.7631 | 0.7631 | 1 | grab 0.76 | left 0.04 | right 0.04 | -29.0 | 23.23 | True | S0 old wiring (VDD ~1.8 V)
clips/supanut/S0/forward/forward_01.wav | forward | forward | forward | 1 | 0.9565 | 0.9565 | 1 | forward 0.96 | _unknown_ 0.02 | home 0.01 | -34.8 | 24.82 | True | S0 old wiring (VDD ~1.8 V)
clips/supanut/S0/station/station_03.wav | station | station | station | 1 | 0.9134 | 0.9134 | 1 | station 0.91 | base 0.07 | _unknown_ 0.00 | -32.0 | 21.03 | True | S0 old wiring (VDD ~1.8 V)
clips/supanut/S0/place/place_05.wav | place | place | place | 1 | 0.6021 | 0.6021 | 1 | place 0.60 | base 0.26 | right 0.06 | -30.0 | 23.09 | True | S0 old wiring (VDD ~1.8 V)
clips/supanut/S0/_unknown_/phone_01.wav | phone | _unknown_ | home | 0 | 0.4725 | 0.0511 | 3 | home 0.47 | forward 0.43 | _unknown_ 0.05 | -35.4 | 24.42 | True | S0 old wiring (VDD ~1.8 V)
clips/supanut/S0/backward/backward_06.wav | backward | backward | backward | 1 | 0.9956 | 0.9956 | 1 | backward 1.00 | black box 0.00 | _unknown_ 0.00 | -30.0 | 18.94 | False | sound longer than 1 s - the clip cuts it; S0 old wiring (VDD ~1.8 V)
clips/supanut/S0/place/place_06.wav | place | place | base | 0 | 0.5047 | 0.3165 | 2 | base 0.50 | place 0.32 | yes 0.04 | -32.7 | 18.83 | True | S0 old wiring (VDD ~1.8 V)
clips/supanut/S0/hand/hand_03.wav | hand | hand | hand | 1 | 0.9945 | 0.9945 | 1 | hand 0.99 | _unknown_ 0.00 | home 0.00 | -31.6 | 17.19 | False | sound longer than 1 s - the clip cuts it; S0 old wiring (VDD ~1.8 V)
clips/supanut/S0/_unknown_/moon_01.wav | moon | _unknown_ | move | 0 | 0.5756 | 0.0394 | 4 | move 0.58 | home 0.22 | forward 0.08 | -41.4 | 23.7 | True | S0 old wiring (VDD ~1.8 V)
clips/supanut/S0/hand/hand_04.wav | hand | hand | hand | 1 | 0.9965 | 0.9965 | 1 | hand 1.00 | _unknown_ 0.00 | pick 0.00 | -31.2 | 21.18 | True | S0 old wiring (VDD ~1.8 V)
clips/supanut/S0/_unknown_/go_01.wav | go | _unknown_ | home | 0 | 0.7894 | 0.0248 | 3 | home 0.79 | hand 0.05 | _unknown_ 0.02 | -33.9 | 27.44 | True | S0 old wiring (VDD ~1.8 V)
clips/supanut/S0/station/station_04.wav | station | station | station | 1 | 0.8521 | 0.8521 | 1 | station 0.85 | base 0.14 | place 0.00 | -30.8 | 21.67 | True | S0 old wiring (VDD ~1.8 V)
clips/supanut/S0/forward/forward_02.wav | forward | forward | forward | 1 | 0.9678 | 0.9678 | 1 | forward 0.97 | _unknown_ 0.02 | home 0.01 | -34.5 | 27.23 | True | S0 old wiring (VDD ~1.8 V)
clips/supanut/S0/move/move_04.wav | move | move | move | 1 | 0.5725 | 0.5725 | 1 | move 0.57 | no 0.20 | _unknown_ 0.05 | -41.1 | 26.44 | True | S0 old wiring (VDD ~1.8 V)
clips/supanut/S0/left/left_02.wav | left | left | left | 1 | 0.7577 | 0.7577 | 1 | left 0.76 | move 0.09 | yes 0.02 | -31.3 | 22.96 | True | S0 old wiring (VDD ~1.8 V)
clips/supanut/S0/_unknown_/foam_01.wav | foam | _unknown_ | home | 0 | 0.9 | 0.014 | 4 | home 0.90 | right 0.03 | forward 0.02 | -37.3 | 26.15 | True | S0 old wiring (VDD ~1.8 V)
clips/supanut/S0/station/station_05.wav | station | station | station | 1 | 0.7744 | 0.7744 | 1 | station 0.77 | base 0.18 | place 0.01 | -31.4 | 20.1 | True | S0 old wiring (VDD ~1.8 V)
clips/supanut/S0/red_box/red_box_03.wav | red box | red box | red box | 1 | 0.9152 | 0.9152 | 1 | red box 0.92 | green box 0.07 | _unknown_ 0.01 | -31.6 | 23.48 | True | S0 old wiring (VDD ~1.8 V)
clips/supanut/S0/backward/backward_07.wav | backward | backward | backward | 1 | 0.9931 | 0.9931 | 1 | backward 0.99 | _unknown_ 0.00 | red box 0.00 | -31.0 | 15.91 | False | sound longer than 1 s - the clip cuts it; S0 old wiring (VDD ~1.8 V)
clips/supanut/S0/yes/yes_01.wav | yes | yes | yes | 1 | 0.9843 | 0.9843 | 1 | yes 0.98 | left 0.01 | place 0.00 | -32.9 | 24.39 | True | S0 old wiring (VDD ~1.8 V)
clips/supanut/S0/station/station_06.wav | station | station | station | 1 | 0.6942 | 0.6942 | 1 | station 0.69 | base 0.27 | _unknown_ 0.01 | -30.0 | 21.29 | True | S0 old wiring (VDD ~1.8 V)
clips/supanut/S0/home/home_04.wav | home | home | home | 1 | 0.9319 | 0.9319 | 1 | home 0.93 | forward 0.02 | _unknown_ 0.01 | -39.6 | 18.94 | False | sound longer than 1 s - the clip cuts it; S0 old wiring (VDD ~1.8 V)
clips/supanut/S0/right/right_03.wav | right | right | right | 1 | 0.9982 | 0.9982 | 1 | right 1.00 | _unknown_ 0.00 | grab 0.00 | -27.5 | 26.41 | True | S0 old wiring (VDD ~1.8 V)
clips/supanut/S0/home/home_05.wav | home | home | home | 1 | 0.9567 | 0.9567 | 1 | home 0.96 | hand 0.02 | move 0.01 | -37.9 | 20.96 | True | S0 old wiring (VDD ~1.8 V)
clips/supanut/S0/forward/forward_03.wav | forward | forward | forward | 1 | 0.9565 | 0.9565 | 1 | forward 0.96 | _unknown_ 0.02 | home 0.01 | -33.8 | 24.22 | True | S0 old wiring (VDD ~1.8 V)
clips/supanut/S0/_unknown_/bright_01.wav | bright | _unknown_ | right | 0 | 0.997 | 0.0007 | 3 | right 1.00 | grab 0.00 | _unknown_ 0.00 | -28.3 | 24.09 | True | S0 old wiring (VDD ~1.8 V)
clips/supanut/S0/left/left_03.wav | left | left | left | 1 | 0.919 | 0.919 | 1 | left 0.92 | yes 0.03 | move 0.02 | -31.8 | 24.63 | False | other sound outside the clip (2 words? click?); S0 old wiring (VDD ~1.8 V)
clips/supanut/S0/_unknown_/open_01.wav | open | _unknown_ | home | 0 | 0.6535 | 0.0969 | 3 | home 0.65 | forward 0.11 | _unknown_ 0.10 | -35.6 | 24.52 | True | S0 old wiring (VDD ~1.8 V)
clips/supanut/S0/hand/hand_05.wav | hand | hand | hand | 1 | 0.9969 | 0.9969 | 1 | hand 1.00 | _unknown_ 0.00 | pick 0.00 | -29.1 | 24.16 | True | S0 old wiring (VDD ~1.8 V)
clips/supanut/S0/yes/yes_02.wav | yes | yes | place | 0 | 0.3684 | 0.0321 | 7 | place 0.37 | base 0.20 | _silence_ 0.10 | -37.8 | 16.0 | False | sound longer than 1 s - the clip cuts it; S0 old wiring (VDD ~1.8 V)
clips/supanut/S0/pick/pick_02.wav | pick | pick | pick | 1 | 0.9944 | 0.9944 | 1 | pick 0.99 | hand 0.00 | right 0.00 | -36.2 | 16.41 | True | S0 old wiring (VDD ~1.8 V)
clips/supanut/S0/forward/forward_04.wav | forward | forward | forward | 1 | 0.9798 | 0.9798 | 1 | forward 0.98 | _unknown_ 0.01 | home 0.00 | -35.4 | 24.64 | True | S0 old wiring (VDD ~1.8 V)
clips/supanut/S0/blue_box/blue_box_05.wav | blue box | blue box | blue box | 1 | 0.6048 | 0.6048 | 1 | blue box 0.60 | green box 0.10 | no 0.09 | -35.2 | 22.38 | True | S0 old wiring (VDD ~1.8 V)
clips/supanut/S0/stop/stop_04.wav | stop | stop | stop | 1 | 0.9785 | 0.9785 | 1 | stop 0.98 | red box 0.00 | green box 0.00 | -31.9 | 18.97 | True | S0 old wiring (VDD ~1.8 V)
clips/supanut/S0/_unknown_/robot_01.wav | robot | _unknown_ | red box | 0 | 0.4052 | 0.116 | 3 | red box 0.41 | green box 0.12 | _unknown_ 0.12 | -35.1 | 22.74 | True | S0 old wiring (VDD ~1.8 V)
clips/supanut/S0/left/left_04.wav | left | left | left | 1 | 0.8692 | 0.8692 | 1 | left 0.87 | yes 0.05 | pick 0.02 | -32.9 | 17.33 | False | sound longer than 1 s - the clip cuts it; S0 old wiring (VDD ~1.8 V)
clips/supanut/S0/stop/stop_05.wav | stop | stop | stop | 1 | 0.9883 | 0.9883 | 1 | stop 0.99 | _unknown_ 0.00 | drop 0.00 | -28.9 | 22.16 | True | S0 old wiring (VDD ~1.8 V)
clips/supanut/S0/drop/drop_02.wav | drop | drop | drop | 1 | 0.8259 | 0.8259 | 1 | drop 0.83 | grab 0.11 | _unknown_ 0.01 | -31.5 | 24.34 | True | S0 old wiring (VDD ~1.8 V)
clips/supanut/S0/_unknown_/wait_01.wav | wait | _unknown_ | right | 0 | 0.4715 | 0.1114 | 3 | right 0.47 | place 0.26 | _unknown_ 0.11 | -32.1 | 19.73 | True | S0 old wiring (VDD ~1.8 V)
clips/supanut/S0/blue_box/blue_box_06.wav | blue box | blue box | blue box | 1 | 0.2264 | 0.2264 | 1 | blue box 0.23 | green box 0.16 | no 0.13 | -35.7 | 22.3 | True | S0 old wiring (VDD ~1.8 V)
clips/supanut/S0/base/base_04.wav | base | base | base | 1 | 0.6904 | 0.6904 | 1 | base 0.69 | place 0.27 | move 0.01 | -36.4 | 17.58 | True | S0 old wiring (VDD ~1.8 V)
clips/supanut/S0/blue_box/blue_box_07.wav | blue box | blue box | blue box | 1 | 0.3931 | 0.3931 | 1 | blue box 0.39 | no 0.28 | red box 0.11 | -34.4 | 25.13 | True | S0 old wiring (VDD ~1.8 V)
clips/supanut/S0/left/left_05.wav | left | left | left | 1 | 0.9816 | 0.9816 | 1 | left 0.98 | yes 0.01 | move 0.00 | -31.1 | 21.0 | True | S0 old wiring (VDD ~1.8 V)
clips/supanut/S0/place/place_07.wav | place | place | place | 1 | 0.5297 | 0.5297 | 1 | place 0.53 | base 0.32 | _unknown_ 0.04 | -30.1 | 19.77 | True | S0 old wiring (VDD ~1.8 V)
clips/supanut/S0/no/no_03.wav | no | no | no | 1 | 0.9881 | 0.9881 | 1 | no 0.99 | _unknown_ 0.00 | move 0.00 | -36.6 | 23.65 | True | S0 old wiring (VDD ~1.8 V)
clips/supanut/S0/grab/grab_07.wav | grab | grab | grab | 1 | 0.8785 | 0.8785 | 1 | grab 0.88 | right 0.03 | drop 0.02 | -28.2 | 20.98 | False | sound longer than 1 s - the clip cuts it; S0 old wiring (VDD ~1.8 V)
clips/supanut/S0/_unknown_/blue_01.wav | blue | _unknown_ | no | 0 | 0.8562 | 0.0092 | 3 | no 0.86 | move 0.12 | _unknown_ 0.01 | -38.3 | 23.87 | True | S0 old wiring (VDD ~1.8 V)
clips/supanut/S0/move/move_05.wav | move | move | move | 1 | 0.4866 | 0.4866 | 1 | move 0.49 | no 0.18 | hand 0.12 | -39.3 | 25.43 | True | S0 old wiring (VDD ~1.8 V)
clips/supanut/S0/no/no_04.wav | no | no | no | 1 | 0.9872 | 0.9872 | 1 | no 0.99 | _unknown_ 0.00 | drop 0.00 | -37.7 | 18.82 | True | S0 old wiring (VDD ~1.8 V)
clips/supanut/S0/base/base_05.wav | base | base | base | 1 | 0.6549 | 0.6549 | 1 | base 0.65 | place 0.30 | move 0.01 | -36.7 | 16.74 | True | S0 old wiring (VDD ~1.8 V)
clips/supanut/S0/_unknown_/bag_01.wav | bag | _unknown_ | left | 0 | 0.8672 | 0.0081 | 8 | left 0.87 | move 0.03 | backward 0.03 | -30.6 | 17.09 | True | S0 old wiring (VDD ~1.8 V)
clips/supanut/S0/_unknown_/groove_01.wav | groove | _unknown_ | move | 0 | 0.812 | 0.0277 | 3 | move 0.81 | home 0.08 | _unknown_ 0.03 | -40.4 | 26.41 | True | S0 old wiring (VDD ~1.8 V)
