Potaeeatsthis/2026-micro-con/voice_command_research/workspace/experiments/board_S1.md

# Board recordings S1: model by model

S1 = fixed wiring, 290 clips (10 per command, 30 _unknown_, 60 room _silence_). Its _unknown_ takes include 'write', which sounds like 'right'.

Clip cells: correct/takes (mean over the fold models when a model has folds). Stream cells: detected/takes.

| model | fold_models | clip_accuracy | clip_macro_f1 | command_accuracy | stream_detected | stream_wrong | unknown_false_alarms | noise_false_alarms |
|:---|---:|---:|---:|---:|---:|---:|:---|---:|
| deployed_w16d2_noaug | 1 | 0.541 | 0.38  | 0.47  | 0.38  | 45 | 15.0/30 | 0 |
| exp01_tcresnet-w16d2_aug-all | 1 | 0.876 | 0.872 | 0.965 | 0.825 | 3 | 13.0/30 | 0 |
| exp02_tcresnet-w16d2_aug-basic | 1 | 0.841 | 0.825 | 0.915 | 0.77  | 7 | 13.0/30 | 0 |
| exp03_tcresnet-w16d2_aug-all_mswc-cap1000 | 1 | 0.862 | 0.852 | 0.945 | 0.815 | 8 | 16.0/30 | 0 |
| exp04_tcresnet-w16d3_aug-all | 1 | 0.893 | 0.892 | 0.99  | 0.925 | 4 | 16.0/30 | 0 |
| exp05_tcresnet-w24d2_aug-all | 1 | 0.876 | 0.872 | 0.96  | 0.835 | 6 | 18.0/30 | 0 |
| exp08_tcresnet-w16d4_aug-all | 1 | 0.879 | 0.876 | 0.97  | 0.94  | 8 | 17.0/30 | 0 |
| exp09_tcresnet-w16d3_aug-all_rhyme-unknown15 | 1 | 0.903 | 0.905 | 0.975 | 0.94  | 5 | 15.0/30 | 0 |

| word | takes | deployed_w16d2_noaug clip | deployed_w16d2_noaug stream | exp01_tcresnet-w16d2_aug-all clip | exp01_tcresnet-w16d2_aug-all stream | exp02_tcresnet-w16d2_aug-basic clip | exp02_tcresnet-w16d2_aug-basic stream | exp03_tcresnet-w16d2_aug-all_mswc-cap1000 clip | exp03_tcresnet-w16d2_aug-all_mswc-cap1000 stream | exp04_tcresnet-w16d3_aug-all clip | exp04_tcresnet-w16d3_aug-all stream | exp05_tcresnet-w24d2_aug-all clip | exp05_tcresnet-w24d2_aug-all stream | exp08_tcresnet-w16d4_aug-all clip | exp08_tcresnet-w16d4_aug-all stream | exp09_tcresnet-w16d3_aug-all_rhyme-unknown15 clip | exp09_tcresnet-w16d3_aug-all_rhyme-unknown15 stream |
|:---|---:|:---|:---|:---|:---|:---|:---|:---|:---|:---|:---|:---|:---|:---|:---|:---|:---|
| move | 10 | 0.0/10 | 0.0/10 | 8.0/10 | 5.0/10 | 6.0/10 | 3.0/10 | 9.0/10 | 8.0/10 | 10.0/10 | 8.0/10 | 9.0/10 | 5.0/10 | 9.0/10 | 9.0/10 | 9.0/10 | 10.0/10 |
| pick | 10 | 1.0/10 | 0.0/10 | 10.0/10 | 10.0/10 | 10.0/10 | 10.0/10 | 10.0/10 | 10.0/10 | 10.0/10 | 10.0/10 | 10.0/10 | 10.0/10 | 10.0/10 | 10.0/10 | 10.0/10 | 10.0/10 |
| grab | 10 | 0.0/10 | 0.0/10 | 10.0/10 | 7.0/10 | 8.0/10 | 5.0/10 | 9.0/10 | 9.0/10 | 10.0/10 | 10.0/10 | 8.0/10 | 8.0/10 | 8.0/10 | 9.0/10 | 10.0/10 | 10.0/10 |
| blue box  | 10 | 0.0/10 | 0.0/10 | 9.0/10 | 2.0/10 | 10.0/10 | 8.0/10 | 10.0/10 | 8.0/10 | 10.0/10 | 10.0/10 | 10.0/10 | 8.0/10 | 10.0/10 | 9.0/10 | 10.0/10 | 10.0/10 |
| green box | 10 | 0.0/10 | 0.0/10 | 10.0/10 | 10.0/10 | 10.0/10 | 10.0/10 | 10.0/10 | 10.0/10 | 10.0/10 | 10.0/10 | 10.0/10 | 10.0/10 | 10.0/10 | 10.0/10 | 10.0/10 | 10.0/10 |
| red box | 10 | 0.0/10 | 0.0/10 | 10.0/10 | 10.0/10 | 7.0/10 | 4.0/10 | 9.0/10 | 5.0/10 | 9.0/10 | 8.0/10 | 9.0/10 | 5.0/10 | 8.0/10 | 6.0/10 | 6.0/10 | 4.0/10 |
| black box | 10 | 0.0/10 | 0.0/10 | 8.0/10 | 2.0/10 | 6.0/10 | 1.0/10 | 8.0/10 | 0.0/10 | 10.0/10 | 5.0/10 | 8.0/10 | 0.0/10 | 10.0/10 | 7.0/10 | 10.0/10 | 10.0/10 |
| hand | 10 | 2.0/10 | 0.0/10 | 10.0/10 | 10.0/10 | 10.0/10 | 10.0/10 | 10.0/10 | 10.0/10 | 10.0/10 | 10.0/10 | 10.0/10 | 10.0/10 | 10.0/10 | 10.0/10 | 10.0/10 | 10.0/10 |
| station | 10 | 9.0/10 | 7.0/10 | 10.0/10 | 7.0/10 | 10.0/10 | 9.0/10 | 10.0/10 | 6.0/10 | 10.0/10 | 10.0/10 | 10.0/10 | 6.0/10 | 10.0/10 | 9.0/10 | 10.0/10 | 9.0/10 |
| base | 10 | 3.0/10 | 0.0/10 | 10.0/10 | 8.0/10 | 10.0/10 | 9.0/10 | 5.0/10 | 4.0/10 | 9.0/10 | 5.0/10 | 8.0/10 | 7.0/10 | 10.0/10 | 10.0/10 | 10.0/10 | 7.0/10 |
| forward | 10 | 10.0/10 | 10.0/10 | 10.0/10 | 10.0/10 | 10.0/10 | 10.0/10 | 9.0/10 | 7.0/10 | 10.0/10 | 10.0/10 | 10.0/10 | 10.0/10 | 10.0/10 | 10.0/10 | 10.0/10 | 10.0/10 |
| backward  | 10 | 10.0/10 | 10.0/10 | 10.0/10 | 10.0/10 | 10.0/10 | 10.0/10 | 10.0/10 | 10.0/10 | 10.0/10 | 10.0/10 | 10.0/10 | 10.0/10 | 10.0/10 | 10.0/10 | 10.0/10 | 10.0/10 |
| left | 10 | 10.0/10 | 8.0/10 | 10.0/10 | 10.0/10 | 10.0/10 | 10.0/10 | 10.0/10 | 10.0/10 | 10.0/10 | 10.0/10 | 10.0/10 | 10.0/10 | 10.0/10 | 10.0/10 | 10.0/10 | 10.0/10 |
| right | 10 | 10.0/10 | 9.0/10 | 10.0/10 | 10.0/10 | 10.0/10 | 10.0/10 | 10.0/10 | 10.0/10 | 10.0/10 | 10.0/10 | 10.0/10 | 10.0/10 | 10.0/10 | 10.0/10 | 10.0/10 | 10.0/10 |
| place | 10 | 7.0/10 | 1.0/10 | 8.0/10 | 6.0/10 | 7.0/10 | 2.0/10 | 10.0/10 | 8.0/10 | 10.0/10 | 10.0/10 | 10.0/10 | 9.0/10 | 9.0/10 | 9.0/10 | 10.0/10 | 9.0/10 |
| drop | 10 | 2.0/10 | 1.0/10 | 10.0/10 | 9.0/10 | 9.0/10 | 5.0/10 | 10.0/10 | 9.0/10 | 10.0/10 | 10.0/10 | 10.0/10 | 10.0/10 | 10.0/10 | 10.0/10 | 10.0/10 | 10.0/10 |
| yes | 10 | 10.0/10 | 10.0/10 | 10.0/10 | 10.0/10 | 10.0/10 | 10.0/10 | 10.0/10 | 10.0/10 | 10.0/10 | 10.0/10 | 10.0/10 | 10.0/10 | 10.0/10 | 10.0/10 | 10.0/10 | 10.0/10 |
| no | 10 | 10.0/10 | 10.0/10 | 10.0/10 | 10.0/10 | 10.0/10 | 10.0/10 | 10.0/10 | 10.0/10 | 10.0/10 | 10.0/10 | 10.0/10 | 10.0/10 | 10.0/10 | 10.0/10 | 10.0/10 | 10.0/10 |
| home | 10 | 0.0/10 | 0.0/10 | 10.0/10 | 9.0/10 | 10.0/10 | 8.0/10 | 10.0/10 | 9.0/10 | 10.0/10 | 9.0/10 | 10.0/10 | 9.0/10 | 10.0/10 | 10.0/10 | 10.0/10 | 9.0/10 |
| stop | 10 | 10.0/10 | 10.0/10 | 10.0/10 | 10.0/10 | 10.0/10 | 10.0/10 | 10.0/10 | 10.0/10 | 10.0/10 | 10.0/10 | 10.0/10 | 10.0/10 | 10.0/10 | 10.0/10 | 10.0/10 | 10.0/10 |
| _unknown_ | 30 | 3.0/30 | | 1.0/30 | | 1.0/30 | | 1.0/30 | | 1.0/30 | | 2.0/30 | | 1.0/30 | | 7.0/30 | |
| _silence_ | 60 | 60.0/60 | | 60.0/60 | | 60.0/60 | | 60.0/60 | | 60.0/60 | | 60.0/60 | | 60.0/60 | | 60.0/60 | |
