Potaeeatsthis/2026-micro-con/voice_command_research/workspace/experiments/board_S0_totals.csv

model | fold_models | clip_accuracy | clip_macro_f1 | command_accuracy | stream_detected | stream_wrong | unknown_false_alarms | noise_false_alarms
deployed_w16d2_noaug | 1 | 0.45 | 0.411 | 0.511 | 0.128 | 37.0 | 11.0/15 | 0.0
exp01_tcresnet-w16d2_aug-all | 1 | 0.826 | 0.838 | 0.957 | 0.287 | 3.0 | 5.0/15 | 0.0
exp02_tcresnet-w16d2_aug-basic | 1 | 0.817 | 0.827 | 0.936 | 0.266 | 2.0 | 3.0/15 | 0.0
exp03_tcresnet-w16d2_aug-all_mswc-cap1000 | 1 | 0.807 | 0.82 | 0.925 | 0.298 | 2.0 | 3.0/15 | 0.0
exp04_tcresnet-w16d3_aug-all | 1 | 0.844 | 0.855 | 0.968 | 0.319 | 1.0 | 6.0/15 | 0.0
exp05_tcresnet-w24d2_aug-all | 1 | 0.853 | 0.862 | 0.968 | 0.308 | 1.0 | 4.0/15 | 0.0
exp08_tcresnet-w16d4_aug-all | 1 | 0.862 | 0.878 | 0.979 | 0.287 | 7.0 | 5.0/15 | 0.0
exp09_tcresnet-w16d3_aug-all_rhyme-unknown15 | 1 | 0.862 | 0.868 | 0.968 | 0.33 | 1.0 | 4.0/15 | 0.0
