Potaeeatsthis/2026-micro-con/voice_command_research/workspace/experiments/board_S1_totals.csv

model | fold_models | clip_accuracy | clip_macro_f1 | command_accuracy | stream_detected | stream_wrong | unknown_false_alarms | noise_false_alarms
deployed_w16d2_noaug | 1 | 0.541 | 0.38 | 0.47 | 0.38 | 45.0 | 15.0/30 | 0.0
exp01_tcresnet-w16d2_aug-all | 1 | 0.876 | 0.872 | 0.965 | 0.825 | 3.0 | 13.0/30 | 0.0
exp02_tcresnet-w16d2_aug-basic | 1 | 0.841 | 0.825 | 0.915 | 0.77 | 7.0 | 13.0/30 | 0.0
exp03_tcresnet-w16d2_aug-all_mswc-cap1000 | 1 | 0.862 | 0.852 | 0.945 | 0.815 | 8.0 | 16.0/30 | 0.0
exp04_tcresnet-w16d3_aug-all | 1 | 0.893 | 0.892 | 0.99 | 0.925 | 4.0 | 16.0/30 | 0.0
exp05_tcresnet-w24d2_aug-all | 1 | 0.876 | 0.872 | 0.96 | 0.835 | 6.0 | 18.0/30 | 0.0
exp08_tcresnet-w16d4_aug-all | 1 | 0.879 | 0.876 | 0.97 | 0.94 | 8.0 | 17.0/30 | 0.0
exp09_tcresnet-w16d3_aug-all_rhyme-unknown15 | 1 | 0.903 | 0.905 | 0.975 | 0.94 | 5.0 | 15.0/30 | 0.0
