Potaeeatsthis/2026-micro-con/voice_command_research/workspace/experiments/exp01_tcresnet-w16d2_aug-all/results/board/exp01_tcresnet-w16d2_aug-all/S0/stream_per_class.csv

cls | takes | hit | hit_extra | wrong | miss | false_alarm | rejected | detected_rate | wrong_as | mean_max_p_true
move | 5 | 1 | 0 | 0 | 4 | 0 | 0 | 0.2 |  | 0.303
pick | 2 | 1 | 0 | 0 | 1 | 0 | 0 | 0.5 |  | 0.501
grab | 7 | 4 | 0 | 0 | 3 | 0 | 0 | 0.571 |  | 0.475
blue box | 7 | 0 | 0 | 1 | 6 | 0 | 0 | 0.0 | no 1 | 0.174
green box | 6 | 0 | 0 | 0 | 6 | 0 | 0 | 0.0 |  | 0.003
red box | 3 | 1 | 0 | 1 | 1 | 0 | 0 | 0.333 | right 1 | 0.633
black box | 4 | 1 | 0 | 0 | 3 | 0 | 0 | 0.25 |  | 0.182
hand | 5 | 1 | 0 | 0 | 4 | 0 | 0 | 0.2 |  | 0.203
station | 6 | 2 | 0 | 0 | 4 | 0 | 0 | 0.333 |  | 0.275
base | 5 | 1 | 0 | 0 | 4 | 0 | 0 | 0.2 |  | 0.144
forward | 4 | 2 | 0 | 0 | 2 | 0 | 0 | 0.5 |  | 0.486
backward | 7 | 0 | 0 | 1 | 6 | 0 | 0 | 0.0 | left 1 | 0.206
left | 5 | 2 | 0 | 0 | 3 | 0 | 0 | 0.4 |  | 0.358
right | 3 | 0 | 0 | 0 | 3 | 0 | 0 | 0.0 |  | 0.005
place | 7 | 2 | 0 | 0 | 5 | 0 | 0 | 0.286 |  | 0.362
drop | 2 | 2 | 0 | 0 | 0 | 0 | 0 | 1.0 |  | 0.833
yes | 2 | 2 | 0 | 0 | 0 | 0 | 0 | 1.0 |  | 0.988
no | 4 | 1 | 0 | 0 | 3 | 0 | 0 | 0.25 |  | 0.252
home | 5 | 2 | 0 | 0 | 3 | 0 | 0 | 0.4 |  | 0.393
stop | 5 | 2 | 0 | 0 | 3 | 0 | 0 | 0.4 |  | 0.399
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
