Potaeeatsthis/2026-micro-con/voice_command_research/workspace/experiments/exp01_tcresnet-w16d2_aug-all/results/board/exp01_tcresnet-w16d2_aug-all/S0/stream_takes.csv

raw_path | word | label | outcome | first_detection | detections | max_avg_p_true | peak_top3 | channels_used | max_snr_db
raw/supanut/S0/move/move_01_raw.wav | move | move | hit | move | move@1.31s 0.92 | 0.953 | move 0.95 | no 0.02 | _unknown_ 0.00 | ch1 | 12.9
raw/supanut/S0/stop/stop_01_raw.wav | stop | stop | hit | stop | stop@1.31s 0.87 | 0.978 | stop 0.98 | _unknown_ 0.00 | drop 0.00 | ch1 | 23.9
raw/supanut/S0/black_box/black_box_01_raw.wav | black box | black box | hit | black box | black box@1.61s 0.72 | 0.725 | black box 0.72 | red box 0.12 | backward 0.03 | ch1 | 26.9
raw/supanut/S0/grab/grab_01_raw.wav | grab | grab | hit | grab | grab@1.51s 0.73 | 0.725 | grab 0.73 | left 0.11 | right 0.05 | ch1 | 24.5
raw/supanut/S0/home/home_01_raw.wav | home | home | hit | home | home@1.01s 0.97 | 0.973 | home 0.97 | hand 0.01 | forward 0.00 | ch0/ch1 | 14.6
raw/supanut/S0/blue_box/blue_box_01_raw.wav | blue box | blue box | miss |  |  | 0.001 | _silence_ 0.93 | left 0.01 | pick 0.01 | ch0 | 22.9
raw/supanut/S0/home/home_02_raw.wav | home | home | miss |  |  | 0.011 | _silence_ 0.85 | left 0.02 | pick 0.02 | ch0 | 22.6
raw/supanut/S0/red_box/red_box_01_raw.wav | red box | red box | wrong | right | right@1.01s 0.76 | 0.971 | red box 0.97 | green box 0.01 | black box 0.01 | ch1 | 20.5
raw/supanut/S0/place/place_01_raw.wav | place | place | hit | place | place@1.31s 0.91 | 0.936 | place 0.94 | base 0.03 | _unknown_ 0.01 | ch1 | 20.2
raw/supanut/S0/backward/backward_01_raw.wav | backward | backward | wrong | left | left@1.01s 0.79 | 0.997 | backward 1.00 | black box 0.00 | left 0.00 | ch1 | 27.5
raw/supanut/S0/station/station_01_raw.wav | station | station | miss |  |  | 0.001 | _silence_ 0.96 | left 0.00 | pick 0.00 | ch0 | 31.6
raw/supanut/S0/pick/pick_01_raw.wav | pick | pick | miss |  |  | 0.009 | _silence_ 0.92 | left 0.01 | pick 0.01 | ch0 | 31.0
raw/supanut/S0/black_box/black_box_02_raw.wav | black box | black box | miss |  |  | 0.002 | _silence_ 0.87 | pick 0.02 | left 0.02 | ch0 | 37.9
raw/supanut/S0/hand/hand_01_raw.wav | hand | hand | miss |  |  | 0.007 | _silence_ 0.92 | left 0.01 | pick 0.01 | ch0 | 35.6
raw/supanut/S0/_unknown_/pink_01_raw.wav | pink | _unknown_ | rejected |  |  | 0.002 | _silence_ 0.93 | pick 0.01 | left 0.01 | ch0 | 36.8
raw/supanut/S0/move/move_02_raw.wav | move | move | miss |  |  | 0.003 | _silence_ 0.95 | left 0.01 | pick 0.01 | ch0 | 37.4
raw/supanut/S0/backward/backward_02_raw.wav | backward | backward | miss |  |  | 0.005 | _silence_ 0.91 | pick 0.01 | left 0.01 | ch0 | 37.2
raw/supanut/S0/green_box/green_box_01_raw.wav | green box | green box | miss |  |  | 0.003 | _silence_ 0.83 | left 0.02 | pick 0.02 | ch0 | 38.8
raw/supanut/S0/base/base_01_raw.wav | base | base | miss |  |  | 0.004 | _silence_ 0.89 | left 0.01 | pick 0.01 | ch0 | 38.3
raw/supanut/S0/green_box/green_box_02_raw.wav | green box | green box | miss |  |  | 0.001 | _silence_ 0.95 | left 0.01 | pick 0.01 | ch0 | 31.2
raw/supanut/S0/no/no_01_raw.wav | no | no | miss |  |  | 0.002 | _silence_ 0.94 | left 0.01 | home 0.01 | ch0 | 41.3
raw/supanut/S0/blue_box/blue_box_02_raw.wav | blue box | blue box | miss |  |  | 0.001 | _silence_ 0.91 | pick 0.01 | left 0.01 | ch0 | 37.6
raw/supanut/S0/_unknown_/nose_01_raw.wav | nose | _unknown_ | rejected |  |  | 0.001 | _silence_ 0.96 | pick 0.01 | left 0.01 | ch0 | 38.1
raw/supanut/S0/place/place_02_raw.wav | place | place | miss |  |  | 0.002 | _silence_ 0.95 | pick 0.01 | left 0.01 | ch0 | 37.7
raw/supanut/S0/hand/hand_02_raw.wav | hand | hand | miss |  |  | 0.005 | _silence_ 0.92 | backward 0.01 | stop 0.01 | ch0 | 38.2
raw/supanut/S0/right/right_01_raw.wav | right | right | miss |  |  | 0.004 | _silence_ 0.89 | left 0.01 | pick 0.01 | ch0 | 39.4
raw/supanut/S0/grab/grab_02_raw.wav | grab | grab | miss |  |  | 0.006 | _silence_ 0.89 | left 0.02 | pick 0.01 | ch0 | 39.0
raw/supanut/S0/base/base_02_raw.wav | base | base | miss |  |  | 0.003 | _silence_ 0.95 | left 0.01 | pick 0.00 | ch0 | 36.4
raw/supanut/S0/green_box/green_box_03_raw.wav | green box | green box | miss |  |  | 0.001 | _silence_ 0.97 | left 0.00 | pick 0.00 | ch0 | 39.0
raw/supanut/S0/backward/backward_03_raw.wav | backward | backward | miss |  |  | 0.002 | _silence_ 0.97 | left 0.00 | home 0.00 | ch0 | 39.2
raw/supanut/S0/_unknown_/write_01_raw.wav | write | _unknown_ | rejected |  |  | 0.002 | _silence_ 0.94 | left 0.01 | home 0.01 | ch0 | 36.6
raw/supanut/S0/backward/backward_04_raw.wav | backward | backward | miss |  |  | 0.002 | _silence_ 0.96 | hand 0.00 | left 0.00 | ch0 | 38.3
raw/supanut/S0/right/right_02_raw.wav | right | right | miss |  |  | 0.001 | _silence_ 0.96 | hand 0.00 | left 0.00 | ch0 | 40.5
raw/supanut/S0/black_box/black_box_03_raw.wav | black box | black box | miss |  |  | 0.001 | _silence_ 0.92 | left 0.01 | home 0.01 | ch0 | 37.5
raw/supanut/S0/green_box/green_box_04_raw.wav | green box | green box | miss |  |  | 0.003 | _silence_ 0.88 | left 0.02 | pick 0.01 | ch0 | 33.8
raw/supanut/S0/base/base_03_raw.wav | base | base | miss |  |  | 0.005 | _silence_ 0.87 | left 0.01 | move 0.01 | ch0 | 38.0
raw/supanut/S0/_unknown_/mood_01_raw.wav | mood | _unknown_ | rejected |  |  | 0.001 | _silence_ 0.96 | left 0.01 | pick 0.01 | ch0 | 32.3
raw/supanut/S0/green_box/green_box_05_raw.wav | green box | green box | miss |  |  | 0.006 | _silence_ 0.88 | left 0.02 | pick 0.02 | ch0 | 32.7
raw/supanut/S0/red_box/red_box_02_raw.wav | red box | red box | miss |  |  | 0.002 | _silence_ 0.93 | left 0.01 | pick 0.01 | ch0 | 31.5
raw/supanut/S0/stop/stop_02_raw.wav | stop | stop | miss |  |  | 0.004 | _silence_ 0.93 | pick 0.01 | left 0.01 | ch0 | 32.3
raw/supanut/S0/backward/backward_05_raw.wav | backward | backward | miss |  |  | 0.003 | _silence_ 0.92 | left 0.01 | pick 0.01 | ch0 | 31.3
raw/supanut/S0/blue_box/blue_box_03_raw.wav | blue box | blue box | miss |  |  | 0.001 | _silence_ 0.96 | left 0.01 | home 0.00 | ch0 | 34.2
raw/supanut/S0/home/home_03_raw.wav | home | home | miss |  |  | 0.004 | _silence_ 0.95 | left 0.01 | pick 0.01 | ch0 | 30.5
raw/supanut/S0/green_box/green_box_06_raw.wav | green box | green box | miss |  |  | 0.001 | _silence_ 0.92 | left 0.01 | pick 0.01 | ch0 | 33.1
raw/supanut/S0/grab/grab_03_raw.wav | grab | grab | miss |  |  | 0.007 | _silence_ 0.87 | left 0.01 | drop 0.01 | ch0 | 32.0
raw/supanut/S0/black_box/black_box_04_raw.wav | black box | black box | miss |  |  | 0.001 | _silence_ 0.94 | left 0.01 | pick 0.01 | ch0 | 30.6
raw/supanut/S0/left/left_01_raw.wav | left | left | miss |  |  | 0.01 | _silence_ 0.90 | pick 0.01 | left 0.01 | ch0 | 33.6
raw/supanut/S0/grab/grab_04_raw.wav | grab | grab | hit | grab | grab@1.11s 0.72 | 0.851 | grab 0.85 | right 0.04 | _unknown_ 0.02 | ch1 | 24.8
raw/supanut/S0/station/station_02_raw.wav | station | station | hit | station | station@1.31s 0.80 | 0.916 | station 0.92 | base 0.06 | place 0.01 | ch1 | 20.2
raw/supanut/S0/grab/grab_05_raw.wav | grab | grab | hit | grab | grab@1.21s 0.73 | 0.857 | grab 0.86 | left 0.06 | drop 0.02 | ch1 | 24.1
raw/supanut/S0/drop/drop_01_raw.wav | drop | drop | hit | drop | drop@1.01s 0.84 | 0.835 | drop 0.84 | grab 0.14 | right 0.01 | ch0/ch1 | 22.5
raw/supanut/S0/place/place_03_raw.wav | place | place | hit | place | place@1.01s 0.77 | 0.894 | place 0.89 | base 0.06 | _unknown_ 0.01 | ch1 | 21.7
raw/supanut/S0/move/move_03_raw.wav | move | move | miss |  |  | 0.009 | _silence_ 0.70 | drop 0.06 | left 0.03 | ch0 | 20.2
raw/supanut/S0/no/no_02_raw.wav | no | no | miss |  |  | 0.005 | _silence_ 0.87 | left 0.01 | drop 0.01 | ch0 | 42.8
raw/supanut/S0/blue_box/blue_box_04_raw.wav | blue box | blue box | miss |  |  | 0.006 | _silence_ 0.85 | left 0.02 | hand 0.01 | ch0 | 62.8
raw/supanut/S0/stop/stop_03_raw.wav | stop | stop | miss |  |  | 0.012 | _silence_ 0.83 | left 0.01 | stop 0.01 | ch0 | 58.7
raw/supanut/S0/place/place_04_raw.wav | place | place | miss |  |  | 0.004 | _silence_ 0.91 | left 0.01 | move 0.01 | ch0 | 61.0
raw/supanut/S0/grab/grab_06_raw.wav | grab | grab | miss |  |  | 0.005 | _silence_ 0.85 | backward 0.02 | stop 0.01 | ch0 | 49.5
raw/supanut/S0/forward/forward_01_raw.wav | forward | forward | miss |  |  | 0.001 | _silence_ 0.97 | home 0.00 | drop 0.00 | ch0 | 60.5
raw/supanut/S0/station/station_03_raw.wav | station | station | miss |  |  | 0.007 | _silence_ 0.83 | drop 0.03 | left 0.02 | ch0 | 67.2
raw/supanut/S0/place/place_05_raw.wav | place | place | miss |  |  | 0.693 | place 0.69 | base 0.18 | right 0.05 | ch1 | 23.2
raw/supanut/S0/_unknown_/phone_01_raw.wav | phone | _unknown_ | rejected |  |  | 0.083 | home 0.64 | forward 0.26 | _unknown_ 0.04 | ch0/ch1 | 19.9
raw/supanut/S0/backward/backward_06_raw.wav | backward | backward | miss |  |  | 0.004 | _silence_ 0.81 | left 0.06 | drop 0.03 | ch0 | 69.6
raw/supanut/S0/place/place_06_raw.wav | place | place | miss |  |  | 0.001 | _silence_ 0.98 | left 0.00 | drop 0.00 | ch0 | 59.1
raw/supanut/S0/hand/hand_03_raw.wav | hand | hand | miss |  |  | 0.003 | _silence_ 0.96 | stop 0.01 | drop 0.00 | ch0 | 60.3
raw/supanut/S0/_unknown_/moon_01_raw.wav | moon | _unknown_ | rejected |  |  | 0.0 | _silence_ 0.98 | home 0.01 | left 0.00 | ch0 | 58.8
raw/supanut/S0/hand/hand_04_raw.wav | hand | hand | miss |  |  | 0.003 | _silence_ 0.93 | left 0.01 | home 0.01 | ch0 | 59.0
raw/supanut/S0/_unknown_/go_01_raw.wav | go | _unknown_ | rejected |  |  | 0.001 | _silence_ 0.97 | home 0.01 | left 0.00 | ch0 | 60.9
raw/supanut/S0/station/station_04_raw.wav | station | station | miss |  |  | 0.0 | _silence_ 0.99 | home 0.00 | left 0.00 | ch0 | 59.7
raw/supanut/S0/forward/forward_02_raw.wav | forward | forward | miss |  |  | 0.001 | _silence_ 0.95 | black box 0.01 | home 0.00 | ch0 | 60.3
raw/supanut/S0/move/move_04_raw.wav | move | move | miss |  |  | 0.007 | _silence_ 0.86 | left 0.02 | hand 0.02 | ch0 | 56.0
raw/supanut/S0/left/left_02_raw.wav | left | left | hit | left | left@1.01s 0.81 | 0.811 | left 0.81 | move 0.07 | grab 0.02 | ch0/ch1 | 21.8
raw/supanut/S0/_unknown_/foam_01_raw.wav | foam | _unknown_ | rejected |  |  | 0.011 | _silence_ 0.85 | left 0.02 | hand 0.01 | ch0 | 33.1
raw/supanut/S0/station/station_05_raw.wav | station | station | miss |  |  | 0.007 | _silence_ 0.86 | drop 0.04 | left 0.02 | ch0 | 23.2
raw/supanut/S0/red_box/red_box_03_raw.wav | red box | red box | hit | red box | red box@1.41s 0.87 | 0.925 | red box 0.93 | green box 0.06 | _unknown_ 0.00 | ch1 | 21.3
raw/supanut/S0/backward/backward_07_raw.wav | backward | backward | miss |  |  | 0.429 | backward 0.43 | left 0.22 | forward 0.06 | ch0/ch1 | 23.9
raw/supanut/S0/yes/yes_01_raw.wav | yes | yes | hit | yes | yes@1.01s 0.98 | 0.982 | yes 0.98 | left 0.01 | place 0.00 | ch1 | 20.3
raw/supanut/S0/station/station_06_raw.wav | station | station | hit | station | station@1.51s 0.72 | 0.719 | station 0.72 | base 0.22 | place 0.02 | ch0/ch1 | 23.2
raw/supanut/S0/home/home_04_raw.wav | home | home | miss |  |  | 0.014 | _silence_ 0.71 | drop 0.08 | left 0.02 | ch0 | 40.1
raw/supanut/S0/right/right_03_raw.wav | right | right | miss |  |  | 0.009 | _silence_ 0.80 | left 0.03 | pick 0.02 | ch0 | 51.9
raw/supanut/S0/home/home_05_raw.wav | home | home | hit | home | home@1.01s 0.96 | 0.962 | home 0.96 | hand 0.02 | right 0.00 | ch0/ch1 | 15.4
raw/supanut/S0/forward/forward_03_raw.wav | forward | forward | hit | forward | forward@1.31s 0.96 | 0.962 | forward 0.96 | _unknown_ 0.02 | home 0.01 | ch1 | 19.3
raw/supanut/S0/_unknown_/bright_01_raw.wav | bright | _unknown_ | false_alarm | right | right@1.31s 1.00 | 0.003 | right 1.00 | grab 0.00 | _unknown_ 0.00 | ch0/ch1 | 24.8
raw/supanut/S0/left/left_03_raw.wav | left | left | miss |  |  | 0.017 | _silence_ 0.87 | drop 0.02 | left 0.02 | ch0 | 27.8
raw/supanut/S0/_unknown_/open_01_raw.wav | open | _unknown_ | false_alarm | home | home@1.01s 0.84 | 0.156 | home 0.84 | forward 0.03 | hand 0.02 | ch0/ch1 | 17.8
raw/supanut/S0/hand/hand_05_raw.wav | hand | hand | hit | hand | hand@1.01s 1.00 | 0.997 | hand 1.00 | pick 0.00 | _unknown_ 0.00 | ch0/ch1 | 24.2
raw/supanut/S0/yes/yes_02_raw.wav | yes | yes | hit | yes | yes@1.31s 0.99 | 0.995 | yes 0.99 | left 0.00 | place 0.00 | ch0/ch1 | 24.7
raw/supanut/S0/pick/pick_02_raw.wav | pick | pick | hit | pick | pick@1.01s 0.98 | 0.994 | pick 0.99 | right 0.00 | hand 0.00 | ch0/ch1 | 17.3
raw/supanut/S0/forward/forward_04_raw.wav | forward | forward | hit | forward | forward@1.21s 0.72 | 0.98 | forward 0.98 | _unknown_ 0.01 | home 0.00 | ch1 | 17.6
raw/supanut/S0/blue_box/blue_box_05_raw.wav | blue box | blue box | miss |  |  | 0.629 | blue box 0.63 | no 0.10 | green box 0.10 | ch1 | 17.6
raw/supanut/S0/stop/stop_04_raw.wav | stop | stop | miss |  |  | 0.013 | _silence_ 0.59 | drop 0.05 | backward 0.04 | ch0 | 25.7
raw/supanut/S0/_unknown_/robot_01_raw.wav | robot | _unknown_ | rejected |  |  | 0.14 | red box 0.44 | green box 0.10 | _unknown_ 0.10 | ch1 | 17.5
raw/supanut/S0/left/left_04_raw.wav | left | left | hit | left | left@1.01s 0.94 | 0.942 | left 0.94 | yes 0.02 | move 0.01 | ch0/ch1 | 20.2
raw/supanut/S0/stop/stop_05_raw.wav | stop | stop | hit | stop | stop@1.01s 0.87 | 0.988 | stop 0.99 | _unknown_ 0.00 | drop 0.00 | ch1 | 24.2
raw/supanut/S0/drop/drop_02_raw.wav | drop | drop | hit | drop | drop@1.01s 0.74 | 0.831 | drop 0.83 | grab 0.09 | _unknown_ 0.02 | ch0/ch1 | 21.1
raw/supanut/S0/_unknown_/wait_01_raw.wav | wait | _unknown_ | rejected |  |  | 0.15 | right 0.45 | place 0.22 | _unknown_ 0.12 | ch1 | 20.4
raw/supanut/S0/blue_box/blue_box_06_raw.wav | blue box | blue box | wrong | no | no@1.01s 0.71 | 0.321 | no 0.71 | grab 0.05 | _unknown_ 0.04 | ch1 | 16.7
raw/supanut/S0/base/base_04_raw.wav | base | base | miss |  |  | 0.005 | _silence_ 0.77 | drop 0.03 | left 0.03 | ch0 | 18.9
raw/supanut/S0/blue_box/blue_box_07_raw.wav | blue box | blue box | miss |  |  | 0.257 | no 0.53 | move 0.22 | blue box 0.06 | ch0/ch1 | 21.2
raw/supanut/S0/left/left_05_raw.wav | left | left | miss |  |  | 0.009 | _silence_ 0.94 | left 0.01 | pick 0.01 | ch0 | 62.4
raw/supanut/S0/place/place_07_raw.wav | place | place | miss |  |  | 0.005 | _silence_ 0.82 | backward 0.02 | stop 0.02 | ch0 | 59.9
raw/supanut/S0/no/no_03_raw.wav | no | no | miss |  |  | 0.012 | _silence_ 0.63 | pick 0.13 | drop 0.04 | ch0 | 59.0
raw/supanut/S0/grab/grab_07_raw.wav | grab | grab | hit | grab | grab@1.01s 0.75 | 0.875 | grab 0.88 | right 0.02 | _unknown_ 0.02 | ch0/ch1 | 58.6
raw/supanut/S0/_unknown_/blue_01_raw.wav | blue | _unknown_ | false_alarm | no | no@1.31s 0.75 | 0.039 | no 0.85 | move 0.13 | _unknown_ 0.01 | ch1 | 14.2
raw/supanut/S0/move/move_05_raw.wav | move | move | miss |  |  | 0.545 | move 0.54 | no 0.16 | hand 0.10 | ch1 | 13.4
raw/supanut/S0/no/no_04_raw.wav | no | no | hit | no | no@1.01s 0.99 | 0.987 | no 0.99 | _unknown_ 0.00 | drop 0.00 | ch1 | 15.1
raw/supanut/S0/base/base_05_raw.wav | base | base | hit | base | base@1.51s 0.70 | 0.702 | base 0.70 | place 0.26 | move 0.01 | ch1 | 16.0
raw/supanut/S0/_unknown_/bag_01_raw.wav | bag | _unknown_ | false_alarm | left | left@1.01s 0.91 | 0.021 | left 0.91 | move 0.02 | backward 0.01 | ch1 | 22.3
raw/supanut/S0/_unknown_/groove_01_raw.wav | groove | _unknown_ | false_alarm | move | move@1.01s 0.76 | 0.043 | move 0.77 | home 0.11 | _unknown_ 0.03 | ch1 | 12.2
