Potaeeatsthis/2026-micro-con/voice_command_research/workspace/experiments/exp01_tcresnet-w16d2_aug-all/results/fold2/board/exp01_tcresnet-w16d2_aug-all_fold2/S0/clip_confusion.png

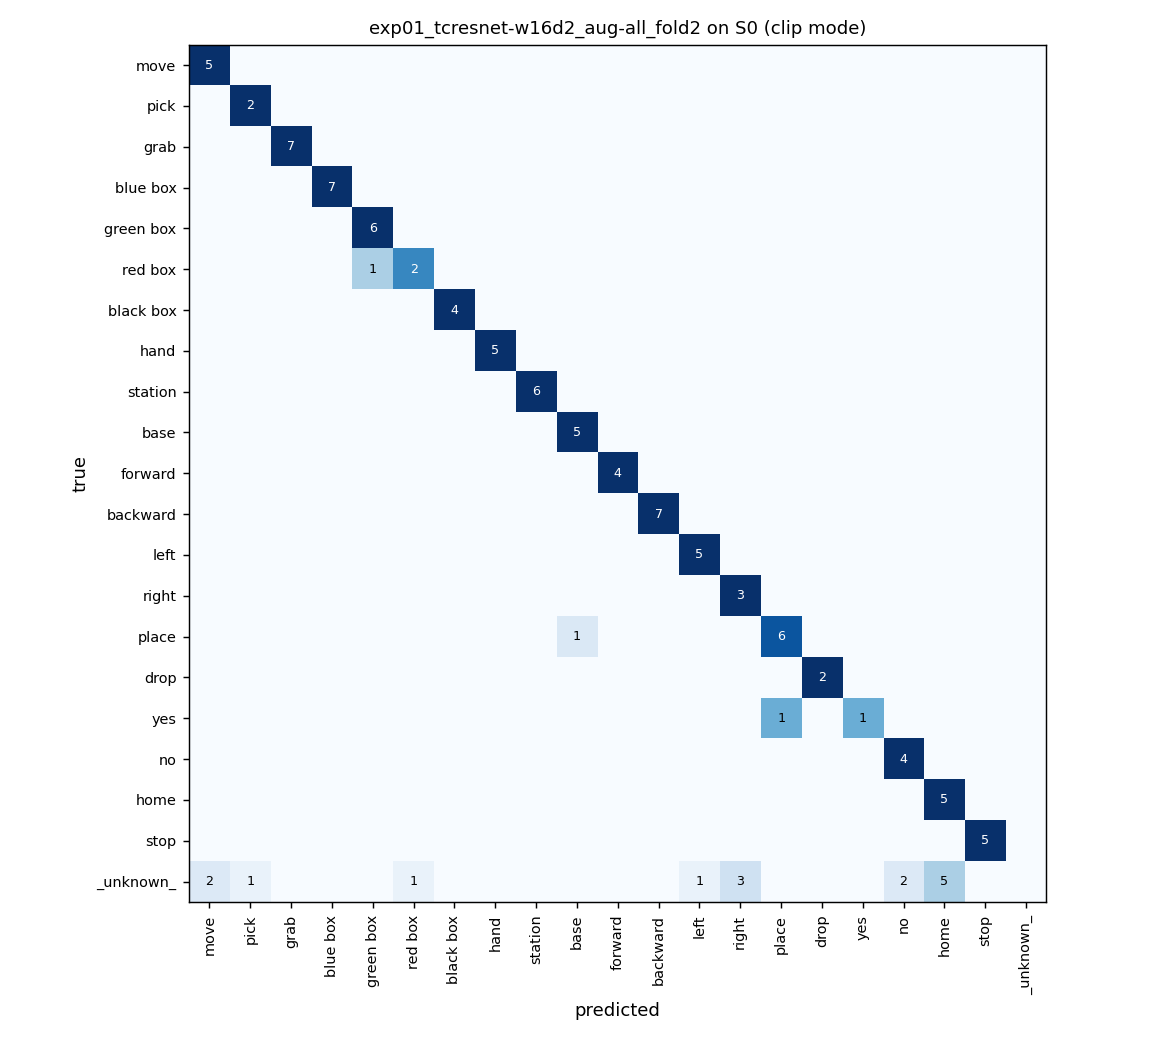
voice_command_research/workspace/experiments/exp01_tcresnet-w16d2_aug-all/results/fold2/board/exp01_tcresnet-w16d2_aug-all_fold2/S0/clip_confusion.png
