Potaeeatsthis/2026-micro-con/voice_command_research/workspace/experiments/exp03_tcresnet-w16d2_aug-all_mswc-cap1000/results/board/exp03_tcresnet-w16d2_aug-all_mswc-cap1000/S0/clip_confusion.png

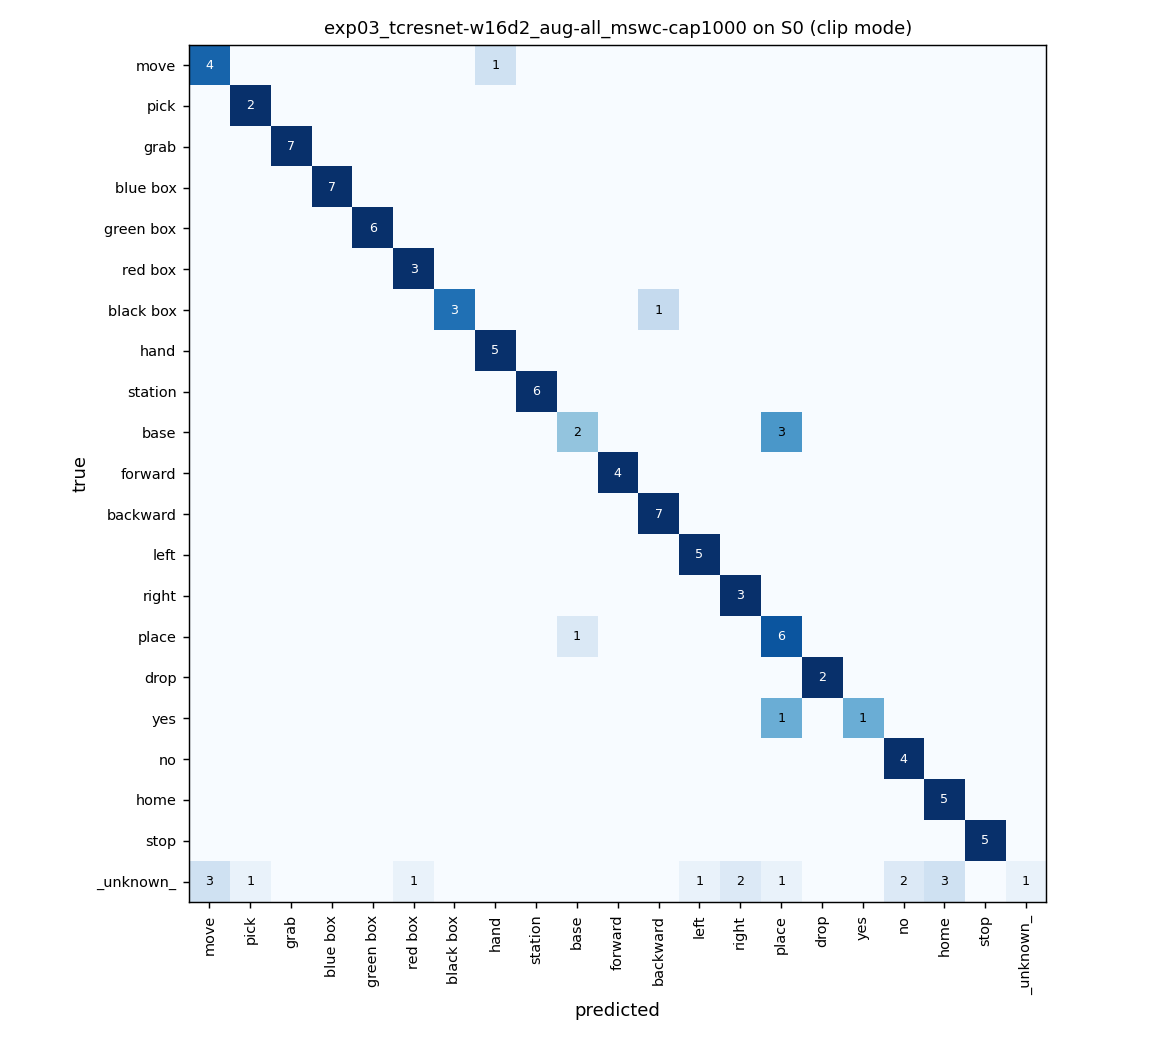
voice_command_research/workspace/experiments/exp03_tcresnet-w16d2_aug-all_mswc-cap1000/results/board/exp03_tcresnet-w16d2_aug-all_mswc-cap1000/S0/clip_confusion.png
