Potaeeatsthis/2026-micro-con/voice_command_research/workspace/experiments/exp05_tcresnet-w24d2_aug-all/results/board/exp05_tcresnet-w24d2_aug-all/S1/clip_confusion.png

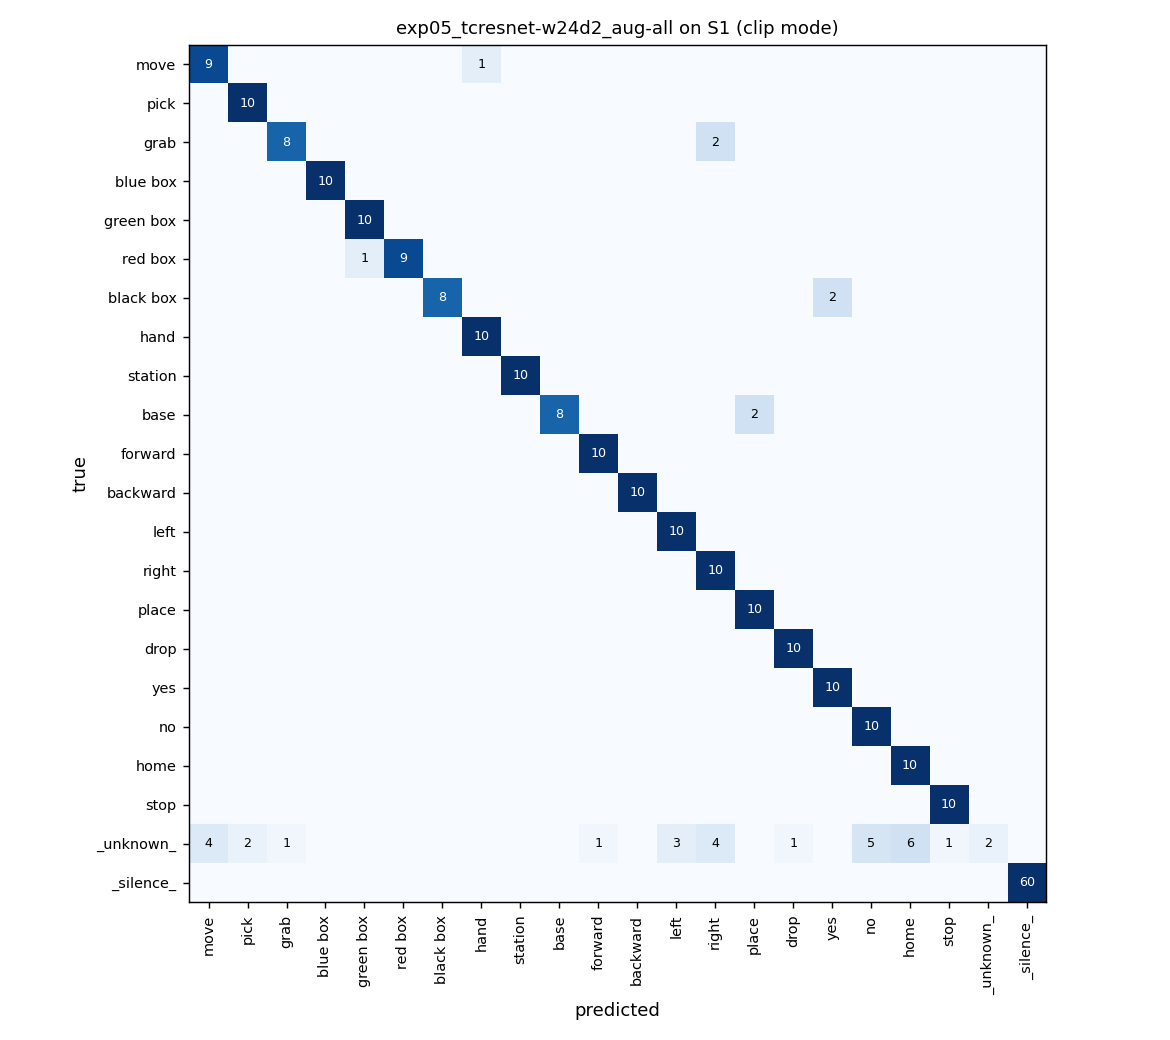
voice_command_research/workspace/experiments/exp05_tcresnet-w24d2_aug-all/results/board/exp05_tcresnet-w24d2_aug-all/S1/clip_confusion.png
