Potaeeatsthis/2026-micro-con/voice_command_research/workspace/experiments/exp09_tcresnet-w16d3_aug-all_rhyme-unknown15/results/board/exp09_tcresnet-w16d3_aug-all_rhyme-unknown15/S1/clip_confusion.png

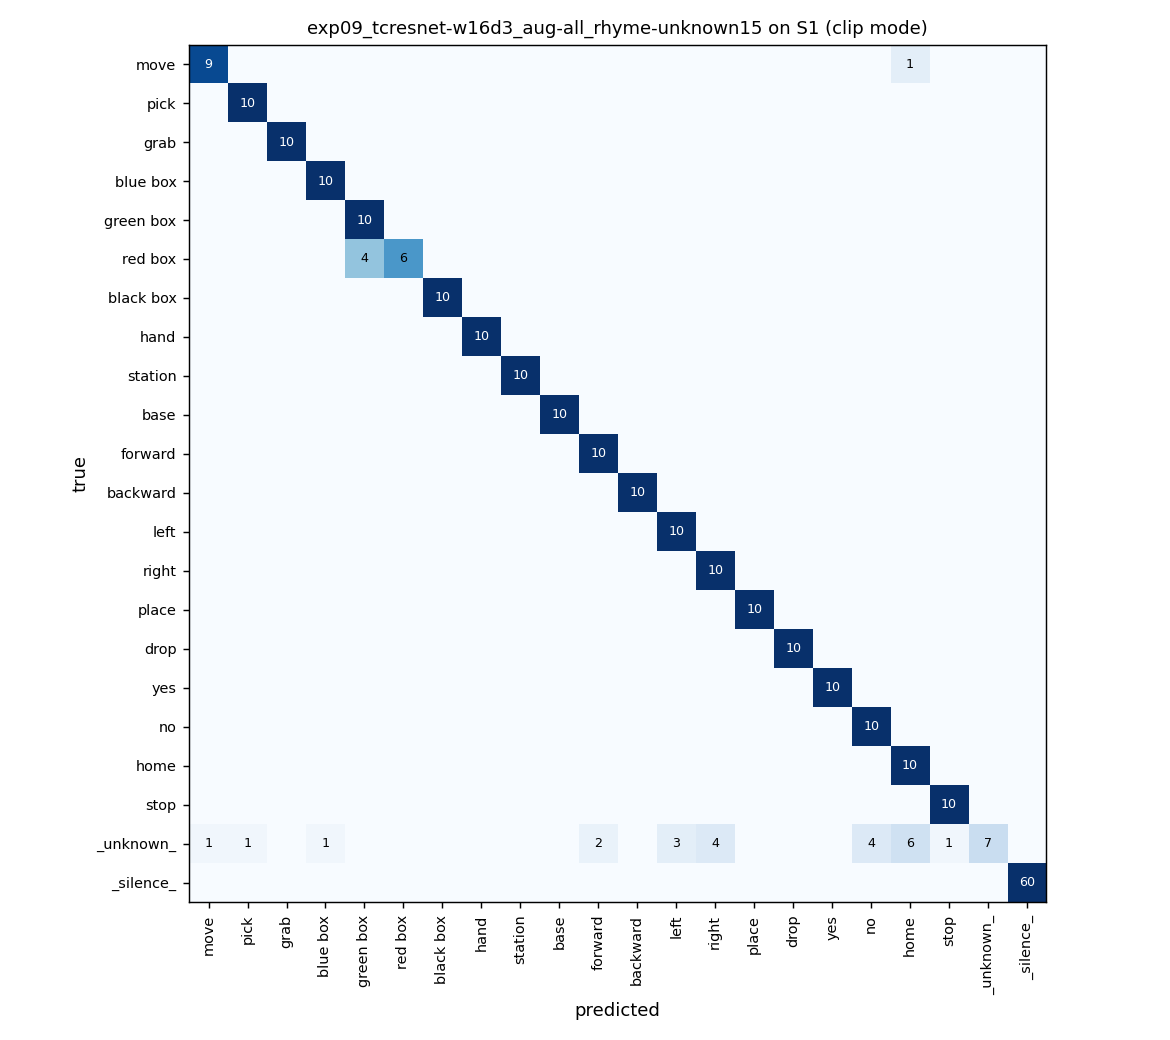
voice_command_research/workspace/experiments/exp09_tcresnet-w16d3_aug-all_rhyme-unknown15/results/board/exp09_tcresnet-w16d3_aug-all_rhyme-unknown15/S1/clip_confusion.png
