Potaeeatsthis/2026-micro-con/(commit log)

2026-08-06 FEAT: Change idea to robotic-arm
2026-09-08 FEAT: Add study directory and organize robotic arm materials
    [robotic-arm-budget.xlsx]
2026-09-08 FEAT: Add stm32 servo pwm guide to study/
2026-10-03 FEAT: Add servo calibrator files
2026-10-20 DOCS(ARM): Update four-mode design and build specification
2026-10-20 DOCS(ARM): Update Voice, IK, UART and Safety Architecture
2026-10-20 DOCS(README): Align Project Overview With Arm Architecture
2026-10-20 DOCS(VOICE): Add planned STM32 voice model and command flow
    Document the TC-ResNet proposal, 21 command labels, confirmation flow, and safe stop behavior. Mark model timing and accuracy as unverified.
2026-10-20 DOCS(SERVO): Add optional servo-rail ADC sensing
    Document the voltage divider, optional parts, CubeMX pin check, rail-loss behavior, and hardware emergency-stop independence.
2026-10-20 DOCS(README): Summarize voice and servo-rail plans
    Update the project overview to mention the planned voice model and optional rail diagnostic.
2026-10-20 DOCS: Fix shared motion pipeline diagram
    Replace the misaligned text diagram with a Mermaid flowchart and clarify which control modes require inverse kinematics.
2026-10-20 DOCS(README): Merge new decisions to the robotic-arm-guide
2026-10-22 core: RoboticArmMain CubeMX config + App skeleton (board-tested: boot ok, voice ok)
2026-10-23 feat: add servo calibration console + kinematics checklist
2026-10-23 DOCS(KINEMATICS): Add calibration-first assembly and FK/IK validation plan
2026-10-23 feat: add STM32 servo calibration + PlatformIO setup
2026-10-23 docs: CubeIDE setup for teammates, drop CODEOWNERS mentions (#3)
    * docs: CubeIDE setup for teammates, drop CODEOWNERS mentions
    * ci: time limits and apt retries so a stalled mirror cannot hang a job
2026-10-23 docs: core-config + AGENTS.md in repo; CI: exempt App/lcd/driver, fake lcd_port for host tests (#4)
2026-10-24 feat: apply measured servo calibration + SG90 gripper mapping
2026-10-24 docs: servo wiring (direct via 330 ohm), HC244 lesson, TIM6/deadband rule, voice timing, signal check (#7)
2026-10-24 feat: input + Pi link text protocol, bench tests (#8)
    * feat: input and pi-link test harness, pi_proto parser, Pi text-v1 bridge
    * docs: inputs and Pi link interface reference; pi_link test cycles all objects
    * feat: pi_bridge service, live reload of calibration and colours, status log
    * feat: input test log shows posted events; joystick/encoder re-check results
    * docs: controls bench test plan; input APP_INPUT_LOG_EVENTS for mode tests
    * feat: log Hold-to-Enable changes in input event log; MODE and Enable bench results
    * feat: input test log mirrors the screen; joystick and encoder in modes bench results
    * docs: step 4 mode switch waits for Enable, bench results
    * docs: controls ben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
2026-10-25 feat: voice task S0-S11 with per-state word filter and dry-run bench flags (#9)
2026-10-26 fix: align wrist mapping with J4 roll and J5 pitch
2026-10-26 feat: lcd UI pages from lcd-test on Lab08 ILI9341 port, calibrated touch
2026-10-26 feat: lcd back to original pictures, mode cards switch without confirm
2026-10-26 docs: core-config v1.3, no e-stop, MODE or hold-to-enable buttons
2026-10-27 DOCS(geometry): Organize arm measurements and document FK calculations
    - Promote the corrected update-7 workbook as the main measurement reference
    - Archive six previous workbook copies without deleting their contents
    - Record the 15 x 25 x 15 mm block and 3.5 mm object-center setback
    - Use the measured-derived 103.5 mm tool length
    - Guard the tool-length formula against a missing tip measurement
    - Link the calculation guide to the main workbook
2026-10-27 DOCS(kinematics): Define robot-frame axes and joint rotation conventions
    - Document the right-handed X-forward, Y-left, Z-up robot frame
    - Define the straight-up reference axes for J1 through J5
    - Distinguish mathematical joint signs from installed servo directions
    - Explain the CAD-to-robot coordinate conversion
    - Keep FK and IK disabled pending geometry integration and calibration
2026-10-27 DOCS(geometry): Renumber archived arm measurement workbooks
    Add the update-1 workbook to the measurement archive.
    Rename update-4, update-5, and update-6 to update-2, update-3, and update-4 respectively. Preserve the contents of all three renamed workbooks.
2026-10-27 Dev (#13)
    * fix: align wrist mapping with J4 roll and J5 pitch
    * feat: lcd UI pages from lcd-test on Lab08 ILI9341 port, calibrated touch
    * feat: lcd 8-bit pixel-art theme in orange/white, same pictures and positions
    * feat: lcd back to original pictures, mode cards switch without confirm
    * docs: core-config v1.3, no e-stop, MODE or hold-to-enable buttons
    * docs: core-config, hold-to-enable dropped, PE7/PE10/PE12 removed
    * core: drop e-stop, MODE and hold-to-enable inputs, manual modes move without enable
    * DOCS(geometry): Organize arm measurements and document FK calculations
    - Promote the corrected update-7 workbook as the main measur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
2026-10-27 feat: STM32 station target (OBJ_STATION, FIND station in voice mode) + host tests; bridge snapshot fix
2026-10-27 ci: install arm-none-eabi-gcc from ARM toolchain action instead of apt
2026-10-27 FIX(motion): Apply installed servo homes and conservative joint limits
    Set startup angles for J1-J6 to 85, 125, 145, 90, 25, and 35 degrees. Keep startup poses separate from kinematic zeros.
    Apply installed limits, including the conservative 100-degree J2 minimum. Leave the incomplete wrist-dependent lower range disabled.
    Replace J6 pulse anchors with 500, 1380, and 2300 microseconds. Verify its 35-degree home produces 842 microseconds.
    Add host checks for home pulses, installed limits, and target clamping. Automatic gripper integration remains blocked by obsolete open/close commands.
2026-10-27 DOCS(calibration): Record installed poses and gripper integration blockers
    Document confirmed homes, conservative ranges, replacement J6 calibration, and observed rotation directions without treating them as kinematic signs.
    Explain that independent joint limits do not guarantee collision-free poses or paths.
    Record required core and modes changes for gripper endpoints, closed-state detection, and command validation before automatic operation.
2026-10-27 FIX(motion): Lower the J2 minimum angle to 90 degrees
    Change the requested shoulder minimum from 100 to 90 degrees while retaining the 125-degree startup home and 180-degree maximum.
    Update host calibration and target-clamping checks to match the new minimum.
    Document observed floor contact around 90-95 degrees with J5 at 25 degrees. The requested minimum is not verified collision-free, and wrist-dependent clearance remains unimplemented.
2026-10-27 FEAT(motion): Enforce coupled shoulder and wrist limits
    Allow J2 down to 50 degrees when J5 is at least 65 degrees; otherwise enforce a 90-degree shoulder minimum.
    Block J5 below 65 degrees while J2 is below 90 degrees without automatically lifting the shoulder.
    Validate current commanded poses and pending endpoints for full-pose and single-joint targets. Enforce the interlock during jogging and control ticks, and discard blocked target values instead of replaying them later.
    Add regression coverage for thresholds, conflicting targets, command ordering, jogging, and blocked-target behavior. Preserve all startup homes.
2026-10-27 DOCS(calibration): Explain coupled limits and automatic-operation blockers
    Document the J2 absolute minimum of 50 degrees and wrist-dependent minimum of 90 degrees, including the 65-degree J5 threshold and target reissue procedure.
    Clarify that the interlock uses commanded angles rather than measured positions and does not compensate for physical servo lag or guarantee collision-free motion.
    Record the voice HOME completion issue when targets are clamped and retain the unresolved gripper open-close integration warning.
2026-10-27 FIX(motion): Gripper 0/60, staged voice HOME, staggered start-up, LCD 180 deg
2026-10-27 TEST(servo): Calibration screen for home and limits (APP_USE_SERVO_CAL_TEST)
2026-10-27 TEST(servo): Route the limit screen through motion, 1 deg steps, table limits in printed rows
2026-10-27 TEST(servo): Show latched fatal faults on the limit screen and ignore input
2026-10-27 TEST(kinematics): Record and verify candidate joint zero mappings
    Document POSE43 reference angles for J1-J5 as 85, 140, 85, 75, and 100 degrees, with observed direction signs +1, -1, +1, +1, and -1.
    Add an offline test for reference-pose zeros, observed one-degree directions, servo-to-model round trips, and unchanged startup-home mappings.
    Keep zero alignment and the J4 reference provisional. Leave firmware constants, startup homes, and FK/IK enablement unchanged; exclude J6 from positioning calculations.
2026-10-27 FEAT(kinematics): Add an offline five-joint FK reference
    Calculate object-center position using measured link lengths and documented CAD offsets, including wrist-roll rotation.
    Update candidate reference angles to J2 145 degrees and J4 87 degrees while preserving observed signs and startup-home values.
    Add checks for angle conversion, reference position, rotation behavior, planar agreement, and finite CLI inputs.
    Keep the model offline and explicitly approximate. Do not change firmware, enable IK, or claim collision safety.
2026-10-27 DOCS(calibration): Record revised reference angles and measured tip heights
    Preserve historical POSE43 and record the revised candidate reference as 85, 145, 85, 87, and 100 degrees for J1-J5.
    Record unloaded jaw-tip heights of 445 and 440 mm from the floor under the base plate at J6 zero degrees.
    Compare the 442.5 mm average with the 442 mm simplified estimate without treating the result as full FK validation.
    Document offline FK usage, hybrid geometry assumptions, the unexplained 5 mm tip difference, and pending wrist-reference validation.
2026-10-27 FIX(motion): Set the gripper startup home to 40 degrees
    Change J6 home from 35 to 40 degrees, producing 891 microseconds with the existing pulse calibration.
    Preserve J6 pulse anchors, the 0-60 degree range, and all other joint homes.
    Update startup pulse and calibration-screen regression checks for the new gripper home.
2026-10-27 TEST(kinematics): Update candidate references and corrected gripper measurements
    Set candidate J1-J5 zeros to 85, 145, 88, 88, and 96 degrees while preserving observed signs and historical POSE43 data.
    Update the unchanged J1-J5 startup-home mapping to model angles 0, 20, 57, 2, and 71 degrees.
    Record the corrected gear alignment, equal 445 mm closed jaw-tip heights, and the held object's 446 mm top-face height.
    Document the derived 438.5 mm object-center height under the level-top assumption. Mark earlier inconsistent readings as superseded without claiming full FK validation.
    Record the 40-degree J6 startup home separately from the unspecified loaded holding angle.
2026-10-27 FEAT(kinematics): Add the corrected CAD kinematics workbook
    Add offline FK and fixed-roll IK calculators with candidate servo signs, installed joint limits, and J2/J5 endpoint coupling checks.
    Record the reference-pose measurement repeats, J6 holding angle of 20 degrees, and the preliminary 85-to-100-to-85 degree J1 rotation check.
    Separate physical observations from model predictions and correct coordinate-marking, orientation, and validation guidance.
    Add regression checks for workbook inputs, formulas, invalid selections, endpoint boundaries, and recalculated results.
2026-10-27 FEAT(kinematics): Implement guarded forward and inverse solvers
    Configure the candidate workbook geometry, joint references, and servo direction signs.
    Implement roll-aware forward kinematics and fixed-roll inverse kinematics with seed-based elbow selection, periodic angle handling, installed limits, and current-to-target J2/J5 coupling checks.
    Preserve the gripper angle and leave outputs unchanged on calculation failure.
    Keep ARM_GEOMETRY_MEASURED disabled by default so existing firmware motion paths remain unchanged.
    Add host coverage for numerical results, round trips, invalid inputs, limits, output preservation, and the default activation guard. Document model assumptions and integra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
2026-10-27 feat(kinematics): show estimated FK position, keep IK disabled
    Split the guards: ARM_FK_ENABLED (1) enables kin_fk for the LCD's estimated X/Y/Z; ARM_GEOMETRY_MEASURED (0) stays the IK activation guard. Cartesian mode stays blocked unless kin_ik_enabled(). Label the X/Y/Z rows as estimated; document activation and the board check.
2026-10-27 feat(lcd): follow the mode's joint/group selection and show FINE/FAST
    Single Joint and Joint Group own the selection (mode_single_joint_selected, mode_joint_group_selected); the LCD < / > arrows post EVT_TOUCH_SELECT like a knob click, and the pages redraw from the mode's selection. Add a FINE/FAST tag on the manual pages. Host test drives the touch flow.
2026-10-28 feat(modes): search grasp pitch and reject clamped IK targets
2026-10-28 docs(ik): document pitch search, exact targets and bench move
2026-10-28 docs(ik): pitch holds only at the waypoints
2026-10-28 fix(input): stamp button events with their press edge time
2026-10-28 fix(ik): arm the bench on a new press edge
2026-10-28 docs(ik): pitch is requested only at waypoints
2026-10-28 FEAT(cartesian): Enable isolated Cartesian IK control
    Add a dedicated Cartesian solver entry point enabled independently of the global IK guard. Keep voice IK blocked and disable the Cartesian entry point in bench builds.
    Enter Cartesian mode at fine speed without commanding movement. Reject entry when wrist roll differs from its reference by more than 2.1 degrees.
    Hold motion on rejected targets and rebase subsequent increments on the held pose, preventing retries from resuming cancelled requests.
    Add regression coverage for activation isolation, roll alignment, encoder and joystick control, gripper preservation, and rejection recovery.
2026-10-28 DOCS(kinematics): Document Cartesian activation and supervised testing
    Explain the separate FK, Cartesian IK, global IK, and bench activation guards.
    Document fine-speed entry, wrist-roll alignment, fixed-pitch limitations, and control-origin rebasing after a rejected target.
    Clarify that centring the joystick does not cancel an accepted target and that joint interpolation provides no collision-free or straight-line path guarantee.
    Update stale calibration notes and describe the supervised board-validation procedure.
2026-10-28 feat: camera-to-robot calibration (--add-point, --solve-calib report) + servo-cal arrow-key tool
    - pi_vision_uart.py: --add-point X Y Z measures one block (median of 40 frames) and appends the
    camera/robot pair to points.csv; --solve-calib prints per-point error, flags outliers, RMS and
    the camera pose in robot coordinates
    - test_calib_sim.py: simulated calibration (RMS 1.5 mm, camera pose within 3 mm)
    - docs/camera-calibration.md: full procedure (setup, commands, reading the output, checking,
    troubleshooting) and the 28 Oct result (RMS 8.9 mm, J1 turns ~14 deg short); listed in the
    ProjectDevGuide README
    - code/servo-calibration/servo-cal-keys.ps1: arrow-key front end for the calibr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
2026-10-28 FEAT(cartesian): Add manual pitch control and detailed IK rejections
    Add a mode-owned Z/PITCH selector to the Cartesian LCD page. Keep Z at 5 mm per detent and adjust pitch by 1 degree per detent through the existing IK and exact-target path.
    Report the limiting joint, bound, or J2/J5 coupling condition for the closest failed solution. Preserve installed servo limits, coupling rules, activation guards, and successful solver selection.
    Cover pitch selection, XYZ preservation, refusal handling, and diagnostic results with host tests. Document the controls and orientation limitations.
